robotpicks/rp1/simulation/README.md

# Bonus: DroneCAN-level simulation (no hardware, but real DroneCAN wire traffic)

`rp1_mvp.launch.py use_mock:=true` is the primary way to check the ROS2 architecture with zero
hardware -- see the top-level README and `docs/wiring.md`. It stops at the hardware boundary
though: `mock_components/GenericSystem` loops commands back to states, so nothing below
`vesc_dronecan_driver` is exercised at all.

This directory is that missing step: it runs the **real** `vesc_dronecan_driver` -- actual
DroneCAN framing over a CAN bus, both drive wheels and steering actuators -- against software
stand-ins for the VESCs, using a Linux virtual CAN interface instead of a physical adapter.

## One-time setup: `vcan0`

Requires root (not automatable from a sandboxed session -- run these yourself):
```bash
sudo modprobe vcan
sudo ip link add dev vcan0 type vcan
sudo ip link set up vcan0
```

This doesn't survive a reboot -- the interface is gone until the three commands above are run
again. For a development machine that repeatedly needs `smoke dronecan` or the simulator, make it
permanent with a systemd oneshot unit instead (stack-agnostic -- works regardless of
NetworkManager/networkd/netplan):

```bash
echo vcan | sudo tee /etc/modules-load.d/vcan.conf

sudo tee /etc/systemd/system/vcan0.service <<'EOF'
[Unit]
Description=Bring up virtual CAN interface vcan0
After=network-pre.target
Before=network.target
Wants=network-pre.target

[Service]
Type=oneshot
ExecStart=/sbin/ip link add dev vcan0 type vcan
ExecStart=/sbin/ip link set up vcan0
RemainAfterExit=yes

[Install]
WantedBy=multi-user.target
EOF

sudo systemctl daemon-reload
sudo systemctl enable --now vcan0.service
```

CI doesn't need this -- `.github/workflows/rp1.yml`'s `dronecan-vcan` job creates `vcan0` fresh on
each ephemeral runner.

## Run: drive wheels (`vesc_dronecan_driver`)

The whole thing is wrapped up as one command from the meta repo, which starts both sides, asserts
the round trip, and tears down — this is what CI runs:

```bash
./robotpicks.sh smoke dronecan       # DRONECAN_IFACE=vcan0 by default
```

To drive it by hand instead:

```bash
python3 simulation/sim_vesc_node.py --iface vcan0        # pretends to be the 4 VESCs

source /opt/ros/$ROS_DISTRO/setup.bash
source ros2_ws/install/setup.bash
ros2 launch rp1_bringup rp1_mvp.launch.py can_iface:=vcan0 teleop:=false
```

Then drive it like real hardware: publish a `geometry_msgs/TwistStamped` to
`/diff_drive_controller/cmd_vel`, or drop `teleop:=false` to steer it with a gamepad.
`/joint_states` and `/dynamic_joint_states`
should start showing plausible rpm/voltage/current once `sim_vesc_node.py` receives commands.

`check_dronecan_loopback.py` is the assertion half, usable on its own against an already-running
pair. It publishes a known `TwistStamped`, checks the wheel velocity that comes back in
`/joint_states`, checks per-ESC voltage reaches `/dynamic_joint_states`, then stops publishing and
checks `diff_drive_controller`'s `cmd_vel_timeout` returns the wheels to zero — so it fails if
telemetry never arrives, arrives at the wrong scale, or latches the last command.

The scale check is the interesting one: the commanded speed only survives the round trip
(rad/s → mechanical RPM → ERPM → `sim_vesc_node` → mechanical RPM → rad/s) if `motor_pole_pairs`
in `rp1_drive.urdf` matches `sim_vesc_node.py --pole-pairs`. Both default to 10 (20-pole motor,
10 pole pairs). Run this against
the real hardware component, not `use_mock:=true` — mock leaves the ESC telemetry at NaN and the
voltage phase will (correctly) fail.

## Run: steering actuators (`vesc_dronecan_driver`)

```bash
python3 simulation/sim_actuator_node.py --iface vcan0    # pretends to be the steering VESCs
                                                           # (default actuator_id 5,6; pass
                                                           # --actuator-ids 4,5,6,7 for all 4)

source /opt/ros/$ROS_DISTRO/setup.bash
source ros2_ws/install/setup.bash
# vesc_dronecan_driver talks SocketCAN directly, and ros2_control reads hardware params from the
# robot description only -- so unlike the drive bringup there is no can_iface launch argument
# here. Edit rp1_steering.urdf's <param name="can_iface"> to vcan0 for this test.
ros2 launch rp1_bringup steering_bench.launch.py
```

`sim_vesc_node.py` and `sim_actuator_node.py` can run simultaneously on the same `vcan0` (use
distinct `--node-id` values, they default to 10 and 11 respectively) to exercise the full
4-wheel + 4-steering setup at once.

## Dependencies

`dronecan` and `python-can` (needed by these simulator scripts only, not by the ROS2 stack,
which uses the vendored C libcanard) -- neither
script has a ROS2 dependency, only these.
