robotpicks/rp1/ros2_ws/src/rp1_swerve_controller/README.md

# rp1_swerve_controller

`ros2_control` `controller_interface::ControllerInterface` plugin for rp1's 4-corner swerve
base. On `master` since the `swerve` branch merged (the default MVP bringup still runs
4-wheel-only skid-steer via `diff_drive_controller` — this hasn't replaced that pipeline, just
added an opt-in swerve one alongside it) — see `rp1-specs/requirements.md` ("Why swerve, and what
it needs to do") for the operating modes this needs to support, and
`rp1-specs/software_spec.md`'s "Swerve controller" section for the broader status.

## What's here

- Claims 4 drive velocity command interfaces + 4 steering position command interfaces, named via
  the `drive_joints`/`steering_joints` parameters (each a list of exactly 4 names, in
  front_left/front_right/rear_left/rear_right order — matches `docs/can_id_map.md`'s wheel index
  convention). Also claims a `seek_home` command interface, `home_0deg`/`home_90deg` `<gpio>`
  state interfaces, and a `brake` command interface per steering joint, unless
  `steering_home_sensors_available`/`steering_brake_available` (both default `true`, independent
  of each other) are set `false` — see the homing gate, brake, and Gazebo bullets below for why
  those escape hatches exist.
- Subscribes `~/cmd_vel` (`geometry_msgs/TwistStamped`, matching `rp1_teleop`'s output and
  `diff_drive_controller`'s convention on this ROS 2 release), guarded by the `cmd_vel_timeout`
  staleness watchdog — see its bullet below.
- Lifecycle (`on_init`/`on_configure`/`on_activate`/`on_deactivate`) and `update()` are wired
  end-to-end and safe to load/activate.
- **Real swerve inverse kinematics.** `compute_corner_commands()` decomposes `(vx, vy, wz)` into
  each corner's wheel speed + steering angle at its steering-axis position
  (`half_wheelbase`/`half_track` params), with the angle-flip optimization (rotate ≤90° and
  reverse wheel speed instead of always steering to the literal computed angle) tracked against
  an unwrapped last-commanded-angle per corner.
- **The four operating modes from `rp1-specs/requirements.md`**, selected via `~/mode`
  (`std_msgs/UInt8`, `SwerveMode` in the header):
  - `0` **FULL_SWERVE** (default) — all 4 corners independently steered, as above.
  - `1` **LOCKED_0** — all 4 wheels held at 0°, driven by projecting the same rigid-body-twist
    vector onto that fixed direction — algebraically identical to standard skid-steer
    differential drive (`vx ∓ wz·half_track` per side). `vy` has no effect (can't strafe with
    wheels locked forward).
  - `2` **LOCKED_90** — all 4 wheels held at 90° (pure crab), same projection trick. `vx` has no
    effect (can't drive fore/aft with wheels locked sideways).
  - `3` **TWO_WHEEL** — 2 corners free-steer via the full IK above, the other 2 locked at 0°
    like `LOCKED_0`. **Which 2 is the `two_wheel_steered_corners` parameter** (a list of exactly
    2 of `front_left`/`front_right`/`rear_left`/`rear_right`), not fixed in code — default is
    the front pair (a conventional front-steered vehicle), but one front + one rear, both on one
    side, or diagonal corners are equally valid. Ackermann-like, though not true Ackermann
    geometry (no explicit turn-radius computation) — a deliberate simplification reusing the
    existing per-corner IK/lock machinery.
  - Locked corners skip the angle-flip optimization on purpose — a "locked" wheel should stay
    visually fixed at its locked angle, not flip to the opposite angle with reversed speed even
    though that's motion-equivalent. Unrecognized `~/mode` values fail safe to `FULL_SWERVE`
    rather than erroring.
  - Verified (gtest, with the corners' `home_0deg`/`home_90deg` pre-confirmed so the homing gate
    below doesn't mask the math being checked): `LOCKED_0`/`LOCKED_90`/`TWO_WHEEL` all produced
    exact numeric matches to hand-calculated expected wheel speeds/angles (including the
    front/rear or left/right differential split from `wz`), switching back to `FULL_SWERVE` —
    and an out-of-range mode value — both correctly fall back to the unconstrained IK, and
    overriding `two_wheel_steered_corners` to a non-default pair (`front_left`/`rear_left`,
    a front+rear diagonal-ish pair rather than the default front pair) correctly moved which 2
    corners free-steer.
- **Homing-gated locked-mode transitions.** Fixes the gap `rp1-specs/requirements.md` flagged
  ("a mode switch takes effect immediately based on whatever angle the controller last
  commanded, not a verified position"): `compute_corner_commands()` reads each locked corner's
  live `home_0deg`/`home_90deg` `<gpio>` state every cycle (no separate "have we ever homed"
  bookkeeping needed — a corner that later drives off the reference naturally stops reporting it
  and re-gates the next time a locked mode needs it), via the `steering_home_sensors` parameter
  (4 gpio prefix names, defaulting to `rp1_swerve.urdf`'s `steering_sensors_*` naming). While
  *any* corner that needs a fixed reference for the current mode isn't yet confirmed there, every
  drive wheel is held at zero (the whole chassis, not just that corner — a mix of confirmed and
  unconfirmed locked wheels would drag/scrub if the drive wheels moved) and the corner's
  `seek_home` command interface carries `0.0`/`1.0` (edge-triggered, matching
  `vesc_dronecan_driver`'s convention — `NaN` means no active request, written once confirmed or
  when the corner isn't locked at all this mode). The corner's steering position command still
  targets the locked angle as usual, so it visibly rotates in place to seek its sensor even
  though the chassis doesn't translate. `FULL_SWERVE` never gates on anything (no fixed
  reference to verify). Verified both via gtest (an unhomed `LOCKED_0`/`LOCKED_90` switch holds
  all 4 wheels at zero and requests the right `seek_home` target; confirming the sensor resumes
  driving with the exact previously-verified locked-mode numbers; a partially-homed corner still
  holds the whole chassis; `TWO_WHEEL`'s free-steering pair never gates) and live: against
  `rp1_swerve_mock.launch.py` (mock hardware never confirms homing, since nothing simulates the
  proximity sensors, so `LOCKED_0` correctly holds `/joint_states` at zero indefinitely) and
  against `rp1_swerve_dronecan.launch.py` over `vcan0` (same zero-hold, plus a raw DroneCAN
  sniff confirmed exactly one `COMMAND_TYPE_HOME` `actuator.ArrayCommand` entry per corner
  reaches the wire — not resent every cycle — when switching into `LOCKED_0`).
- **Steering-hold brake**, closing `rp1-specs/requirements.md`'s "Brake on steering requirement"
  gap (the 4:1 spur reduction isn't self-locking, so holding a locked angle without continuously
  drawing motor current needs an actual brake — the firmware side, `bldc`'s `COMMAND_TYPE_BRAKE`,
  already existed; this was the missing `ros2_control` representation). A `brake` command
  interface per steering joint, `vesc_dronecan_driver` sends it as a `COMMAND_TYPE_BRAKE`
  `actuator.Command` entry every cycle — level, not edge-triggered like `seek_home`, so a dropped
  frame self-heals rather than leaving the brake stuck. Engaged (`1.0`) exactly when a corner is
  `locked && confirmed` — the same condition that stops gating drive to zero — released (`0.0`)
  otherwise: free-steering corners, or a locked corner still seeking/unconfirmed (the firmware's
  `homing_tick()` needs the shaft free to turn during the seek, and would otherwise fight an
  engaged brake). Verified both via gtest (engages once confirmed, releases while pending, stays
  released on free-steering corners including `TWO_WHEEL`'s free pair) and live over `vcan0`: the
  brake stays released while `LOCKED_0` is requested but unconfirmed, and a raw wire sniff
  confirmed `COMMAND_TYPE_BRAKE` reaches `actuator.ArrayCommand` continuously (not just once, per
  its level rather than edge-triggered semantics) with the expected value.
- **Mode-switch safety: a requested mode only becomes active once the chassis is confirmed
  actually stopped.** Complements the homing gate above rather than replacing it — that gate
  only fires when a corner's target angle isn't yet confirmed; this one is a blanket rule
  covering every mode transition, including ones where no corner's target angle actually
  changes (e.g. `LOCKED_0`→`TWO_WHEEL`'s default pair, both wanting the same 0° for the locked
  corners). `update()` computes the real (state-feedback-derived) body twist via
  `compute_body_twist()` every cycle; a requested `~/mode` value only overwrites `active_mode_`
  — the mode `compute_corner_commands()` actually acts on — once `vx`/`vy`/`wz` are all below
  `mode_switch_stopped_tolerance` (default 0.02 m/s or rad/s). Until then, the controller keeps
  running the *previous* mode's kinematics rather than freezing or erroring. Fixed a latent bug
  surfaced while adding this: `compute_body_twist()`'s per-corner state reads used
  `get_optional().value_or(0.0)`, which only substitutes for a genuinely empty optional — a
  state interface that hasn't been reported yet reads back as an *engaged* optional wrapping
  NaN (real hardware before its first telemetry frame, or a bare test-harness interface with no
  `initial_value`), which silently poisoned every downstream sum; now explicitly NaN-checked.
  Verified via gtest (a chassis reporting real motion via drive/steering state defers a
  requested switch, keeping the previous mode's exact numbers, then adopts the new mode with
  the previously-verified locked-mode numbers once state reports near-zero; a controller that's
  never received any state feedback is treated as already stopped, matching every other test in
  the suite) and live against `rp1_swerve_mock.launch.py`: requesting `LOCKED_0` while actively
  driving left the FULL_SWERVE steering angles in place, and only snapped to the locked angle
  once a zero `cmd_vel` let the mock-looped-back state settle near zero.
- **Odometry.** `compute_body_twist()` reads back drive velocity + steering position *state*
  (`wheel_radius` param converts angular velocity to linear speed) and solves the same
  rigid-body-twist equations as the IK, in reverse — exact for this controller's always-
  rectangular corner geometry (see the code comment for why it decouples into 3 independent
  averages rather than needing a general least-squares solver). Integrated pose is published as
  `nav_msgs/Odometry` on `~/odom` and broadcast as an `odom_frame_id`→`base_frame_id` TF
  (defaults `odom`/`base_link`, `enable_odom_tf` to disable), matching `diff_drive_controller`'s
  conventions.
- Verified end-to-end against `rp1_bringup`'s `rp1_swerve_mock.launch.py` (mock hardware, real
  `rp1_swerve.urdf`, no CAN/Gazebo): straight, pure lateral/crab, and turn-in-place all produce
  the expected `/joint_states`, including the angle-flip case actually engaging correctly; and
  driving straight for 5s at 1 m/s produced `~/odom` position ≈5.5m and a matching `odom→
  base_link` TF, confirming the robot actually drives across RViz's grid now, not just
  articulates its joints in place. See that launch file for the "watch it before trusting it on
  the robot" bringup.
- **Real DroneCAN hardware path verified for both drive and steering.**
  `rp1_swerve_dronecan.launch.py` (against `vesc_dronecan_driver`, real wire framing over
  `can0`/`vcan0`) drove straight and produced genuine nonzero drive-wheel velocity/position in
  `/joint_states`; a turn-in-place command produced steering positions matching the
  hand-computed full-swerve angles exactly (`±0.5586 rad` on all 4 corners, alternating sign per
  the angle-flip optimization) — both fed back over actual DroneCAN traffic, a meaningfully
  different trust level than the mock-hardware tier, where odometry is computed from state
  that's just last cycle's command looped back. Getting there required fixing three real bugs
  (all in `vesc_dronecan_ros`'s swerve branch except the dronecan driver-dispatch one): (1)
  `dronecan`'s driver-dispatch bug in the simulator scripts; (2) `pumpRx()` passed a hardcoded
  `timestamp_usec=0` to libcanard, which made every multi-frame transfer (`esc.Status`,
  `actuator.Status`) look "never initialized" on its second frame and get silently dropped —
  single-frame transfers (`esc.RPMCommand`, `actuator.ArrayCommand`) were unaffected, which is
  why this went unnoticed until real feedback was checked; (3) `actuator.Status`'s decoder
  hard-failed the *entire* decode (throwing away position/speed/force too, not just the 2
  extension fields) whenever the private `home_0deg`/`home_90deg` extension bits were absent —
  which they always are from a standard, non-extended sender like `sim_actuator_node.py`. The
  extension bits themselves (and `seek_home`/`COMMAND_TYPE_HOME`) still aren't exercised by
  these simulator scripts, since the stock `dronecan` Python codec doesn't know to populate
  them — only a real bldc-flashed VESC (or a simulator taught the extension) would cover that.
- **Gazebo physics wiring, via `rp1_swerve_gazebo.launch.py`.** `gz_ros2_control`'s
  `GazeboSimSystem` replaces `vesc_dronecan_driver`/`mock_components` — the first tier where
  drive/steering feedback comes from an actual simulated rigid-body dynamics solver (inertia,
  gravity, contact), not commands looping straight back to state or a real DroneCAN round-trip
  with no physics at all. GazeboSimSystem only backs standard joint interfaces (position/
  velocity/effort) with a real Gazebo entity, so it can't export `seek_home`/`brake` or any
  `<gpio>` interface (ESC telemetry, `home_0deg`/`home_90deg`) — no Gazebo entity to back those
  with. Since `controller_manager`'s resource manager refuses to activate a controller that
  declares an interface no hardware component exports, this can't be requested-then-tolerated-
  if-missing the way an unexpectedly-absent `steering_home_sensors` name is:
  `steering_home_sensors_available`/`steering_brake_available` parameters (both default `true`)
  tell the controller not to request `seek_home`/`home_0deg`/`home_90deg`/`brake` at all, set to
  `false` for this tier via `rp1_swerve_gazebo_overrides.yaml`. Practically this means home
  confirmation is permanently unavailable under Gazebo (same situation as mock hardware, for the
  same reason — nothing
  simulates the proximity sensors), so only `FULL_SWERVE` drives; `LOCKED_0`/`LOCKED_90`/
  `TWO_WHEEL` stay correctly gated at zero forever. Verified live: both `joint_state_broadcaster`
  and `rp1_swerve_controller` activate cleanly against the spawned model, and driving straight
  produced real closed-loop feedback through actual physics — wheel velocity converging toward
  (not instantly snapping to) the commanded value, `~/odom` and the broadcast TF both advancing
  with real accumulated distance. Two real bugs fixed getting there, both launch-file-level, not
  controller bugs: the URDF's own explanatory comment happened to contain the same placeholder
  text used for the `<parameters>` path substitution, so a naive `count=1` regex replaced the
  comment's occurrence instead of the tag's; and spawners need `--param-file` here exactly like
  the other two tiers already document, even though `gz_ros2_control`'s plugin separately loads
  the same YAML for its own `controller_manager`'s `ros__parameters` (that only covers
  controller *type* declarations, not each controller's own parameters). Two further real bugs
  fixed on top of the above, both discovered while live-testing Gazebo tuning (see the next two
  bullets):
- **Units bug in the drive command: `compute_corner_commands()` sent linear m/s straight to the
  angular (rad/s) velocity command interface.** `compute_body_twist()` (the reverse/odometry
  path) correctly multiplies the state-reported angular velocity by `wheel_radius` to get linear
  speed, but the forward/IK path had no matching divide — every commanded speed reached the wheel
  `wheel_radius` (0.2154) times too fast in the interface's own units, so the physical wheel (and
  the robot) moved at only `wheel_radius` times the commanded m/s (e.g. `vx=1.0` produced ~0.215
  m/s of real motion). Invisible before because odometry is self-consistent with whatever the
  wheel actually did, not compared against the commanded value directly — only surfaced by
  comparing Gazebo's converged `/joint_states` velocity against the independently-computed
  expected value while tuning PID gains. Fixed by dividing by `wheel_radius` in
  `compute_corner_commands()`, matching `compute_body_twist()`'s multiply in reverse. Verified via
  gtest (all `drive_command` expected values recomputed against the corrected units) and live over
  Gazebo (`/joint_states` wheel velocity converges to exactly `commanded_m_s / wheel_radius`
  rad/s, confirmed against `vx=1.0` -> `4.6425` rad/s).
- **Gazebo PID/physics tuning: the URDF was missing `<limit effort="".../>`/`<dynamics
  damping="".../>` on every drive and steering joint, and steering had no declared
  `position_proportional_gain`.** `gz_ros2_control`'s `GazeboSimSystem` only exposes
  `position_proportional_gain` as a real parameter for position control (confirmed via `strings`
  on `libgz_ros2_control-system.so` — no separate velocity gain exists in this version); combined
  with the URDF's total absence of effort/velocity/damping limits, convergence toward a
  step-changed target was implausibly slow. Fixed by adding `<limit effort="10.0"
  velocity="10.0"/>` + `<dynamics damping="0.1" friction="0.0"/>` to the 4 steering joints,
  `<limit effort="20.0" velocity="50.0"/>` + the same damping to the 4 drive joints, and
  `<param name="position_proportional_gain">50.0</param>` to each steering joint's
  `<ros2_control>` block — all untuned placeholders, not measured/optimized values, but enough to
  fix the qualitative sluggishness. Verified live: before/after `/joint_states` comparison showed
  convergence going from "gradually settles over the whole test window" to "near-instant."
- **Mode-switch ramping.** Closes the "no ramping" gap `rp1-specs/requirements.md` flagged: the
  mode-switch-safety gate above only ever *waited* for the chassis to report near-zero twist —
  it never itself commanded a stop, so a caller that kept publishing a nonzero `~/cmd_vel` could
  block a requested switch forever. Now, once a switch is pending (`requested_mode !=
  active_mode_`) and the chassis isn't yet stopped, the raw `~/cmd_vel` is ignored in favor of a
  ramp: `ramp_vx_`/`ramp_vy_`/`ramp_wz_` are seeded from whatever `~/cmd_vel` said the cycle the
  switch first became pending, then decelerated toward zero every cycle at
  `mode_switch_linear_deceleration`/`mode_switch_angular_deceleration` (m/s²/rad/s², both default
  to reasonable-feeling placeholders, not measured/tuned values) regardless of what `~/cmd_vel`
  keeps publishing — so the chassis reliably reaches `mode_switch_stopped_tolerance` and the
  switch lands. Once it does, `~/cmd_vel` passes through unchanged again, same as before this
  feature existed. Verified via gtest (a strictly-decreasing `drive_command` sequence across
  several cycles while `~/cmd_vel` keeps holding its original nonzero value, then settling at
  exactly zero and staying there) and live over Gazebo: requesting `LOCKED_0` while continuously
  publishing `vx=1.0` showed wheel velocity smoothly decelerating from steady-state (~4.64 rad/s)
  to zero over ~2s (matching the default deceleration rate), after which steering committed to
  the locked 0° angle.
- **`cmd_vel` staleness watchdog.** `diff_drive_controller`'s `cmd_vel_timeout`, which the MVP
  skid-steer path already relies on (and CI's DroneCAN loopback check asserts), had no
  counterpart here: `update()` latched the last twist forever, so a dead publisher — teleop
  crash, RC dropout, or just a `ros2 topic pub` that exited — left the robot driving its last
  command indefinitely (observed for real under Gazebo: still strafing at 0.3 m/s a minute after
  the publisher stopped). Now a command whose `header.stamp` is older than `cmd_vel_timeout`
  (seconds, default 0.5, validated > 0) is treated as no command at all: every drive velocity
  goes to zero while the steering positions keep holding the last commanded angle — coasting out
  straight beats snapping the wheels back to 0° mid-roll, which would scrub. Unstamped messages
  are stamped at reception so they age correctly; a fresh command revives driving immediately
  (the watchdog gates on message age, not a latched fault).

## What's not here yet

Nothing currently tracked here — the previously-open "no ramping" and "untuned Gazebo PID gains"
gaps are both closed above.

## Tests

`test/test_rp1_swerve_controller.cpp` — 24 gtest cases, run via `colcon test --packages-select
rp1_swerve_controller`. Builds a real controller instance with real `CommandInterface`/
`StateInterface` objects (not a mock hardware component), drives the actual lifecycle
(`init`/`configure`/`assign_interfaces`/`activate`), and delivers `cmd_vel`/`mode` via real
publishers spun through a `SingleThreadedExecutor` (not direct field writes) so the subscription
wiring itself is exercised, not just the math. Covers straight/crab/turn-in-place (including
asserting the angle-flip optimization's exact expected values on the two corners where it should
engage), `LOCKED_0`/`LOCKED_90`, `TWO_WHEEL` with both the default and an overridden
`two_wheel_steered_corners` pair, the out-of-range-mode fallback, odometry (drives state
interfaces directly, subscribes `~/odom`, checks the published value), the homing gate (an
unhomed `LOCKED_0`/`LOCKED_90` switch holds every drive wheel at zero and issues the right
`seek_home` target, confirming the sensor afterward resumes driving with the same numbers the
non-gated tests check; a partially-homed corner (3 of 4) still holds the whole chassis; `TWO_WHEEL`
gates on its locked pair only, never the free-steering one; and `FULL_SWERVE` never gates
regardless of home state), the mode-switch-safety gate (a chassis reporting real motion via
drive/steering state defers a requested switch, adopting it only once state settles near zero;
a controller that's never received state feedback is treated as already stopped), mode-switch
ramping (a deferred switch's drive command strictly decreases cycle-over-cycle while `~/cmd_vel`
keeps holding its original nonzero value, settling at exactly zero and staying there), the
`cmd_vel` staleness watchdog (a stale command zeroes every drive velocity while steering holds
the last angle; a fresh one within the timeout keeps driving; a non-positive `cmd_vel_timeout`
fails `on_init`), and
`steering_home_sensors_available`/`steering_brake_available:false` (mirroring Gazebo: no
seek_home/home_0deg/home_90deg/brake interfaces assigned at all, not just unconfirmed) -- the
controller still activates and drives `FULL_SWERVE` normally, and `LOCKED_0` stays gated at zero
across several cycles, not just the first. The brake itself: engages once a locked corner is
confirmed, releases while pending, and stays released on `TWO_WHEEL`'s free-steering pair.

Not chainable (`controller_interface::ControllerInterface`, not `ChainableControllerInterface`)
— unlike this ROS 2 release's `diff_drive_controller`/`mecanum_drive_controller`. Revisit only if
something actually needs to chain into/out of this controller; not needed for anything currently
planned.
