robotpicks/rp1/docs/mechanical_request.xlsx

Sheet: 0. Instructions
rp1 — Geometry & Mass Properties Request
Request to Mechanical Design / Запрос в отдел механического проектирования
 | ENGLISH | РУССКИЙ
Document | rp1 — Geometry & Mass Properties Request, Rev A | rp1 — Запрос геометрических данных и массово-инерционных характеристик, ред. A
Date / Дата | 2026-07-26 | 2026-07-26
From / От | Nir Mor — Software / ROS 2 (nir@nadirwave.com) | Нир Мор — ПО / ROS 2 (nir@nadirwave.com)
To / Кому | Mechanical Design | Отдел механического проектирования
Purpose / Цель | The rp1 software stack has no physical description of the robot. Kinematics, odometry and simulation currently run on placeholder numbers (track width 0.5 m, wheelbase 0.5 m, wheel radius 0.1 m) and the URDF is a two-joint skeleton with every joint at the origin. This workbook collects the real values. | В программном стеке rp1 отсутствует физическое описание робота. Кинематика, одометрия и симуляция работают на условных значениях (колея 0,5 м, колёсная база 0,5 м, радиус колеса 0,1 м), а URDF — заготовка из двух шарниров в начале координат. Настоящая книга собирает реальные значения.
How to use / Как заполнять | Fill in only the cream-coloured cells. Sheets 1, 2 and 5 are confirmations; sheets 3, 3.1-3.2 and 4 are numeric values. Do not delete or renumber rows — the Ref column is referenced by the PDF and by the software configuration. | Заполняйте только ячейки кремового цвета. Листы 1, 2 и 5 — подтверждения; листы 3, 3.1-3.2 и 4 — числовые значения. Не удаляйте и не перенумеровывайте строки — графа Ref используется в PDF и в конфигурации ПО.
Units / Единицы | Metres, radians, kilograms. Right-handed frame, X forward / Y left / Z up (ROS REP-103). Confirm on sheet '1. Conventions' before entering any value. | Метры, радианы, килограммы. Правая система координат, X — вперёд / Y — влево / Z — вверх (ROS REP-103). Подтвердите на листе «1. Conventions» до внесения значений.
Source column / Графа Source | CAD = as-designed value from the model. MEAS = measured on built hardware. Every value needs one of the two — both are kept, they do not replace each other. | CAD = значение по конструкторской документации (из модели). MEAS = измерено на изготовленном изделии. Требуется указать для каждого значения — оба набора хранятся и не заменяют друг друга.
Tolerance / Допуск | Give a tolerance per value, or state a blanket tolerance for a group in the Notes column. | Указывайте допуск для каждого значения либо общий допуск на группу в графе «Примечания».
Files / Файлы | The workbook does not replace the file deliverables — see sheet '2. Files' for the STEP, mesh, drawing and mass-property exports requested alongside it. | Книга не заменяет передаваемые файлы — см. лист «2. Files»: STEP, полигональные модели, чертежи и массово-инерционные характеристики запрашиваются дополнительно.
Return to / Вернуть | nir@nadirwave.com — this workbook filled in, plus the files from sheet 2. | nir@nadirwave.com — заполненную книгу и файлы по листу 2.
Legend / Обозначения | Cream cell = to be filled in by mechanical design | Кремовая ячейка = заполняется отделом механики

Sheet: 1. Conventions
§1 — Coordinate frame and conventions / Система координат и соглашения
Agree these BEFORE exchanging any numbers — a mismatch invalidates every value in §3. / Согласовать ДО обмена числами — расхождение обесценивает все значения §3.
Ref | Item (EN) | Пункт (RU) | Requested convention (EN) | Запрашиваемое соглашение (RU) | Confirmed Подтверждено | Comment / Комментарий
1.1 | Units | Единицы измерения | Length in metres, angles in radians, mass in kg | Длина — метры, углы — радианы, масса — кг
1.2 | Handedness | Ориентация системы | Right-handed coordinate system | Правая система координат
1.3 | Axis convention | Направление осей | X forward, Y left, Z up (ROS REP-103) | X — вперёд, Y — влево, Z — вверх (ROS REP-103)
1.4 | base_link origin | Начало координат base_link | Proposed: ground projection of the geometric centre of the four steering axes | Предлагается: проекция на грунт геометрического центра четырёх осей поворота колёс
1.5 | base_link tie-in | Привязка base_link | Offset from base_link to a physical feature measurable on the built frame (e.g. front face of the chassis rail, centreline of a specific bore) — state which feature | Смещение от base_link до физического элемента, измеримого на изготовленной раме (например, передняя плоскость лонжерона, ось конкретного отверстия) — указать, какого именно
1.6 | Assembly datums | Базы сборки | Which faces/features are the primary, secondary and tertiary datums | Какие поверхности/элементы являются основной, вспомогательной и третьей базами
1.7 | Zero pose — steering | Нулевое положение — поворот | Steering angle 0 = wheel plane aligned with +X; positive rotation counter-clockwise about +Z (viewed from above) | Угол поворота 0 = плоскость колеса совпадает с +X; положительное вращение — против часовой стрелки вокруг +Z (вид сверху)
1.8 | Zero pose — drive | Нулевое положение — тяга | Positive wheel rotation = robot moves forward | Положительное вращение колеса = движение робота вперёд
1.9 | Export pose | Положение при экспорте | All geometry exported with the robot in the zero pose defined above | Вся геометрия экспортируется в нулевом положении, определённом выше
1.10 | Unit conversion applied | Применённый пересчёт единиц | CAD packages commonly default to millimetres and Y-up. State the conversion actually applied to the exported files rather than leaving it implied. | В CAD-системах часто приняты миллиметры и ось Y вверх. Явно указать пересчёт, фактически применённый к экспортируемым файлам.

Sheet: 2. Files
§2 — Files requested / Запрашиваемые файлы
The workbook does not replace these exports. / Настоящая книга не заменяет эти файлы.
Ref | Deliverable (EN) | Результат (RU) | Format / Формат | Notes / Примечания | Status Статус | File name(s) / Имена файлов
2.1 | Full assembly, as-designed | Полная сборка по конструкторской документации | STEP AP242 (AP214 acceptable) | Master geometry, in the zero pose of §1 / Эталонная геометрия, в нулевом положении по §1
2.2 | Per-link visual meshes | Полигональные модели (визуальные) по звеньям | Binary STL or Collada .dae, one file per link | Decimated (~10k-100k triangles total), in metres, each file's origin at that link's joint / Упрощённые (~10–100 тыс. треугольников), в метрах, начало координат — в шарнире звена
2.3 | Per-link collision geometry | Геометрия для расчёта столкновений по звеньям | Primitives (box / cylinder / sphere) or convex hulls | Must be separate from 2.2 — the detailed mesh is not usable for collision checking / Должна быть отдельной от 2.2 — детализированная модель непригодна
2.4 | Dimensioned drawings | Чертежи с размерами | PDF | Top, side and front views with datums shown / Виды сверху, сбоку и спереди с указанием баз
2.5 | Mass properties | Массово-инерционные характеристики | CSV or table / CSV или таблица | Per link: mass, centre of mass, 3x3 inertia tensor about the CoM, and the frame it is expressed in / По звену: масса, центр масс, тензор инерции 3×3 относительно ЦМ и система координат
2.6 | Parameter table | Таблица параметров | This workbook / Настоящая книга | Versioned together with the CAD revision / Версионируется совместно с ревизией CAD
2.7 | URDF exporter output (if available) | Результат экспортёра URDF (при наличии) | URDF + meshes | SolidWorks sw_urdf_exporter, Onshape onshape-to-robot, Fusion 360 — supply in addition to 2.6, not instead of it / предоставить в дополнение к 2.6, а не вместо него

Sheet: 3. Parameters
§3 — Geometric parameters (scalar) / Геометрические параметры
Per-corner values are on the '3.1-3.2 Per-corner' sheet. / Значения по углам машины — на листе «3.1-3.2 Per-corner».
Ref | Parameter (EN) | Параметр (RU) | Unit Ед. | Value Значение | Tol. Допуск | Source Источник | Notes / Примечания
3.1 Wheel layout — track and wheelbase / Расположение колёс — колея и база
3.1.1 | Front track width (between wheel contact patch centrelines) | Передняя колея (между центрами пятен контакта) | m / м
3.1.2 | Rear track width (between wheel contact patch centrelines) | Задняя колея (между центрами пятен контакта) | m / м
3.1.3 | Wheelbase (longitudinal distance, front to rear steering axis) | Колёсная база (продольное расстояние между осями поворота) | m / м
3.3 Wheels and tyres / Колёса и шины
3.3.1 | Unloaded wheel radius | Свободный радиус колеса (без нагрузки) | m / м
3.3.2 | Loaded rolling radius at nominal payload | Радиус качения под номинальной нагрузкой | m / м
3.3.3 | Tyre pressure at which 3.3.2 applies | Давление в шине, при котором действует п. 3.3.2 | bar / бар
3.3.4 | Tyre section width | Ширина профиля шины | m / м
3.3.5a | Contact patch length at nominal load | Длина пятна контакта при номинальной нагрузке | m / м
3.3.5b | Contact patch width at nominal load | Ширина пятна контакта при номинальной нагрузке | m / м
3.3.6 | Tread type / part number | Тип протектора / обозначение шины | —
3.4 Steering joints and drivetrain / Механизмы поворота и трансмиссия
3.4.1 | Steering joint: true continuous 360° rotation? | Механизм поворота: непрерывное вращение на 360°? | Yes/No
3.4.2a | If No: steering joint limit, min | Если Нет: предел поворота, мин. | rad / рад
3.4.2b | If No: steering joint limit, max | Если Нет: предел поворота, макс. | rad / рад
3.4.3 | If No: what imposes the limit (cable routing / mechanical stop / other) | Если Нет: чем ограничен ход (прокладка кабеля / механический упор / иное) | —
3.4.4 | Steering reduction ratio, actuator -> steering axis | Передаточное отношение привода поворота, привод → ось поворота | :1
3.4.5 | Drive reduction ratio, motor -> wheel | Передаточное отношение тягового привода, двигатель → колесо | :1
3.4.6 | Backlash referred to the wheel (drive) | Люфт, приведённый к колесу (тяга) | rad / рад
3.4.7 | Backlash referred to the steering axis | Люфт, приведённый к оси поворота | rad / рад
3.4.8 | Max steering rate the mechanism tolerates | Максимальная скорость поворота, допускаемая механизмом | rad/s
3.4.9 | Design max wheel speed | Расчётная максимальная скорость колеса | m/s
3.4.10a | Required wheel torque, continuous | Требуемый момент на колесе, длительный | N·m / Н·м
3.4.10b | Required wheel torque, peak | Требуемый момент на колесе, пиковый | N·m / Н·м
3.4.11 | Required steering torque at standstill on soil | Требуемый момент поворота колеса на месте по грунту | N·m / Н·м
3.5 Envelope, mass and operating limits / Габариты, масса и ограничения
3.5.1a | Overall length | Габаритная длина | m / м
3.5.1b | Overall width | Габаритная ширина | m / м
3.5.1c | Overall height | Габаритная высота | m / м
3.5.2a | Minimum ground clearance | Минимальный дорожный просвет | m / м
3.5.2b | Where the minimum clearance occurs | Место расположения минимального просвета | —
3.5.3a | Approach angle | Угол въезда | rad / рад
3.5.3b | Departure angle | Угол съезда | rad / рад
3.5.4 | Total mass (dry, no payload) | Полная масса (снаряжённая, без полезной нагрузки) | kg / кг
3.5.5a | Static load, front left (FL) | Статическая нагрузка, переднее левое (FL) | kg / кг
3.5.5b | Static load, front right (FR) | Статическая нагрузка, переднее правое (FR) | kg / кг
3.5.5c | Static load, rear left (RL) | Статическая нагрузка, заднее левое (RL) | kg / кг
3.5.5d | Static load, rear right (RR) | Статическая нагрузка, заднее правое (RR) | kg / кг
3.5.6x | Centre of mass in base_link, x | Центр масс в base_link, x | m / м
3.5.6y | Centre of mass in base_link, y | Центр масс в base_link, y | m / м
3.5.6z | Centre of mass in base_link, z | Центр масс в base_link, z | m / м
3.5.7 | Max payload mass | Максимальная полезная нагрузка | kg / кг
3.5.8 | Payload mounting interface pose — enter on sheet '4. Sensor mounts' | Положение посадочного места полезной нагрузки — вносится на листе «4. Sensor mounts» | —
3.5.9a | Rated max slope (drive) | Максимальный преодолеваемый уклон | rad / рад
3.5.9b | Static tip-over angle | Статический угол опрокидывания | rad / рад
3.5.10 | Target row spacing the robot must straddle or pass | Ширина междурядья, которое робот должен проходить или обхватывать | m / м
3.5.11 | Max crop canopy height the robot must pass under | Максимальная высота растительного полога для прохода под ним | m / м

Sheet: 3.1-3.2 Per-corner
§3.1 / §3.2 — Per-corner geometry / Геометрия по углам машины
Steering axis position in base_link, and steering axis geometry. Per-corner values are requested so an asymmetric layout is captured correctly. / Положение оси поворота в base_link и геометрия оси поворота — по каждому углу, чтобы описать несимметричную компоновку.
Corner Угол | Steering axis x [m / м] | Steering axis y [m / м] | Steering axis z [m / м] | Scrub radius / lateral offset, axis -> contact patch centre [m] Плечо обкатки / попер. смещение [м] | Trail / longitudinal offset [m] Продольное смещение (вылет) [м] | Caster angle [rad] Кастер [рад] | Camber angle [rad] Развал [рад] | Source Источник | Notes / Примечания
FL |  |  |  |  |  |  |  |  | Front Left / Переднее левое
FR |  |  |  |  |  |  |  |  | Front Right / Переднее правое
RL |  |  |  |  |  |  |  |  | Rear Left / Заднее левое
RR |  |  |  |  |  |  |  |  | Rear Right / Заднее правое
 | All four corners identical? If yes, fill FL only and note it here. / Все четыре угла идентичны? Если да, заполните только FL и укажите это здесь.

Sheet: 4. Sensor mounts
§4 — Sensor and mount frames / Системы координат посадочных мест
Requested now even though sensor selection is not final — the interfaces must be reserved in the design and the poses feed the ROS 2 transform tree. Pose is of the mount in base_link. / Запрашивается уже сейчас: посадочные места надо зарезервировать, а их положения используются для дерева преобразований TF. Положение задаётся в base_link.
Mount / Посадочное место | x [m / м] | y [m / м] | z [m / м] | roll [rad] крен [рад] | pitch [rad] тангаж [рад] | yaw [rad] рыскание [рад] | Bolt pattern Присоед. размеры | Source Источник | Notes / Примечания
IMU / ИНС
GNSS antenna — phase centre / Антенна ГНСС — фазовый центр
Forward camera / lidar — Передняя камера / лидар
Rear camera / lidar — Задняя камера / лидар
Payload plate (§3.5.8) / Плита полезной нагрузки
Spare mount 1 / Резервное место 1
IMU axis orientation / Ориентация осей IMU | State the IMU axis orientation relative to base_link explicitly, not only the mount pose. A rotated or inverted IMU is the most common source of sign errors in the control loop. / Укажите ориентацию осей IMU относительно base_link явно, а не только положение посадочного места. Повёрнутая или перевёрнутая установка IMU — самая частая причина ошибок в знаках.

Sheet: 5. Process
§5 — Tolerances, revisions and process / Допуски, ревизии и порядок работы
Ref | Item (EN) | Пункт (RU) | Agreed Согласовано | Comment / Комментарий
5.1 | Every value in §3-§4 marked CAD (as-designed) or MEAS (measured on hardware) | Каждое значение в §3–§4 помечено как CAD (по документации) или MEAS (измерено на изделии)
5.2 | Tolerance given for each value, or a blanket tolerance stated for a group | Для каждого значения указан допуск либо задан общий допуск на группу
5.3 | This workbook is issued with each CAD revision, carrying that revision's ID | Настоящая книга выпускается с каждой ревизией CAD и содержит идентификатор этой ревизии
5.4 | Software is notified when any §3 value changes, including "small" changes | О любом изменении значений §3 сообщается разработчикам ПО, включая «незначительные»
 | Rationale for 5.4: these values are duplicated across three ROS 2 configuration files and the robot description. A silent change breaks the correspondence between simulation and hardware in a way no automated test detects. Wheel-odometry calibration on the built robot will refine the effective track width and rolling radius; those calibrated values do not replace the CAD values — both are kept, which is why the CAD/MEAS marking matters. / Обоснование п. 5.4: эти значения продублированы в трёх конфигурационных файлах ROS 2 и в описании робота. Необъявленное изменение нарушает соответствие симуляции и реальной машины так, что автоматические тесты этого не выявляют. Калибровка колёсной одометрии уточнит эффективную колею и радиус качения, но не заменяет значения из CAD — хранятся оба набора.
