robotpicks/rp1/ros2_ws/src/rp1_description/meshes/wheel_front_left.stl

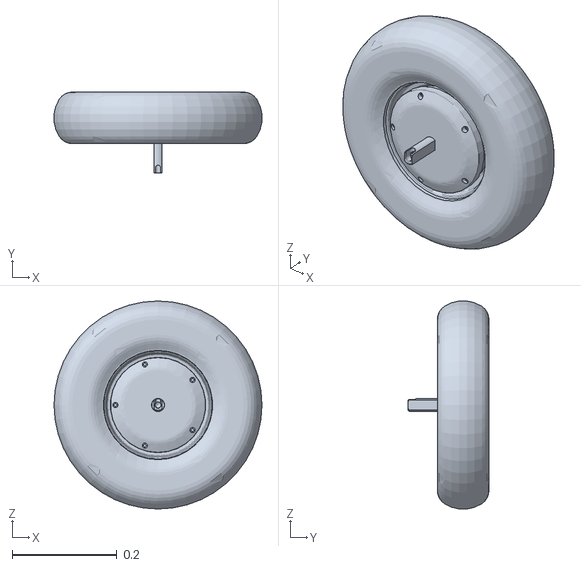
[picture p1: CAD file, 2026-07-27]
ros2_ws/src/rp1_description/meshes/wheel_front_left.stl
0.397 x 0.155 x 0.397
