robotpicks/rp1/(list of files, cad)

Other CAD files:
ros2_ws/src/rp1_description/meshes/wheel_front_right.stl
ros2_ws/src/rp1_description/meshes/wheel_rear_right.stl
