robotpicks/rp1/docs/wiring.md

# Wiring notes (MVP: 4 drive wheels, no steering joints)

## Bus

One CAN bus, PC directly to the 4 VESCs -- no bridge MCU (VESC's UAVCAN CAN mode speaks
DroneCAN natively, see `docs/can_id_map.md`). PC side needs a SocketCAN-capable USB-CAN adapter
(e.g. CANable/candleLight running `gs_usb`, or an Innomaker USB2CAN) so it shows up as a plain
Linux `can0` interface -- no custom driver needed. Bring the interface up before launching:
```bash
sudo ip link set can0 type can tq 63 prop-seg 5 phase-seg1 6 phase-seg2 4 sjw 4
sudo ip link set can0 up
```
Same 1 Mbit/s, 75% sample point as a plain `bitrate 1000000` would give you -- these are that
calculation's own tq/prop-seg/phase-seg1/phase-seg2 values, spelled out explicitly so `sjw` can
be set to 4 instead of the default-computed 2. **Use the explicit form, not `bitrate 1000000`
alone**: bench-confirmed 2026-09-15, at the default `sjw 2` this adapter ran ~60% error-class
frames on the bus (FORM errors at the CRC-sequence/EOF tail, `can state` flapping
ACTIVE/ERROR-PASSIVE) because the VESCs' own CAN controllers run at their hardware max SJW (4 tq
-- see `CAN_BTR_SJW(3)` in the bldc repo's `comm/comm_can.c`) while this adapter defaulted to
half that; matching it dropped the error-class fraction to <0.2%, sustained. If the bitrate's
ever changed, re-derive these five values rather than reuse them: set a plain `bitrate <rate>`
first, read back what `ip -details link show can0` computed, then reissue with `sjw` bumped to
whatever max its `gs_usb:` capability line advertises.

**Or make it permanent**: `tools/80-can0-up.rules` (udev rule, confirmed on the bench
2026-08-05, timing updated 2026-09-15) runs those same two commands automatically on every
boot/replug. No automatic bus-off recovery, though -- this bench's gs_usb adapter firmware
doesn't support `restart-ms` (confirmed 2026-08-05, `ip` refuses it: "Device doesn't support
restart from Bus Off") despite supporting berr-reporting (needed for the per-frame FORM/STUFF/
BIT/CRC detail above) -- the two are evidently independent capabilities on this firmware. A
bus-off still needs a manual down/up (or replug) to clear. Install once:
```bash
sudo cp tools/80-can0-up.rules /etc/udev/rules.d/
sudo udevadm control --reload-rules && sudo udevadm trigger
```
This is deliberately a udev rule (`RUN+=`), not a `systemd-networkd` `.network` file, even though
networkd supports a declarative `[CAN] BitRate=` section: udev bring-up doesn't depend on which
network stack (if any) is active/managing the interface, so it works the same whether a given
machine runs networkd, NetworkManager, or neither. If a machine already has its own
networkd/NetworkManager-based CAN config (some benches do -- check `networkctl status can0` /
`nmcli device status`), that's fine to leave in place alongside this rule; both converging on the
same bitrate/up state isn't a conflict worth resolving, just don't rely on one machine's networkd
setup existing on another.

**Adapter firmware**: confirmed on the bench 2026-08-06 for a MKS CANable V1.0 PRO
(`STM32F072C8Tx` per its schematic). If it enumerates as `1d50:606f` with USB strings `bytewerk`
/ "candleLight USB to CAN adapter" rather than `makerbase` / "CANable-MKS gs_usb", it's running
an old/generic candleLight_fw build -- reflash it with the board-specific one below.

Use the **`CANable_MKS` target from candleLight_fw v2.1**, not the `canable` target from the
v2.0 release archive: `canable` is an F042 target (the original CANable/CANtact design, a
different chip) that happens to run on this board's F072 but isn't actually correct for it;
`CANable_MKS` (F072-specific, matching this board) only exists as of v2.1, which has no
GitHub Release/prebuilt binary -- it must be built from source:
```bash
git clone --recurse-submodules https://github.com/candle-usb/candleLight_fw.git
cd candleLight_fw && git checkout v2.1
mkdir build && cd build
# TOOLCHAIN_BIN_DIR: any arm-none-eabi-gcc works, e.g. bldc/tools/gcc-arm-none-eabi-7-2018-q2-update/bin
# (already vendored in this repo tree) or the apt gcc-arm-none-eabi package -- see toolchain note below.
cmake -DCMAKE_TOOLCHAIN_FILE=../cmake/gcc-arm-none-eabi-8-2019-q3-update.cmake \
      -DCMAKE_BUILD_TYPE=Release -DTOOLCHAIN_BIN_DIR=<arm-none-eabi-gcc bin dir> ..
make CANable_MKS_fw   # -> build/CANable_MKS_fw.bin
```
**Toolchain note (confirmed on the bench 2026-08-06)**: Ubuntu's `gcc-arm-none-eabi` apt
package fails with `cannot read spec file 'nano.specs'` -- `nano.specs` is installed by its
`libnewlib-arm-none-eabi` dependency, but under `/usr/lib/arm-none-eabi/newlib/`, which isn't in
gcc's own spec search path (`arm-none-eabi-gcc -print-search-dirs` doesn't list it). Fix once,
system-wide, with a symlink into the directory gcc actually searches (adjust the `14.2.1` path
component to match `arm-none-eabi-gcc -dumpversion` if it differs):
```bash
sudo ln -s /usr/lib/arm-none-eabi/newlib/nano.specs /usr/lib/gcc/arm-none-eabi/14.2.1/nano.specs
```
Without this fix, the vendored `bldc/tools/gcc-arm-none-eabi-7-2018-q2-update/` toolchain works
unmodified (used instead of the apt package the first time this was built, before the symlink
fix above was found).

Flash via USB-DFU (needs `dfu-util`):
```bash
# Unplug, bridge the J5 (BOOT) jumper, plug back in -- lsusb should now show
# 0483:df11 STMicroelectronics STM Device in DFU Mode instead of 1d50:606f.
sudo dfu-util -d 0483:df11 -c 1 -i 0 -a 0 -s 0x08000000:leave -D CANable_MKS_fw.bin
# Then remove the J5 jumper and replug -- back to 1d50:606f in normal (non-DFU) mode.
```
J2 (4-pin: 3.3V/SWCLK/GND/SWDIO) is an alternative SWD flashing/debug path if a probe is
available, bypassing USB-DFU entirely. J4 (unpopulated by default) bridges a 120 ohm
termination resistor across CAN_H/CAN_L -- separate from the bus-level termination below.

Terminate the bus with 120 ohm resistors at each end per standard CAN wiring practice.

## VESC configuration (one-off, not part of the runtime path)

Each VESC is configured directly over its own USB link using VESC Tool: CAN mode =
**VESC+UAVCAN** (not plain UAVCAN -- see `docs/can_id_map.md` for why), CAN ID (doubles as the
DroneCAN node ID in this mode) + `esc_index` (see `docs/can_id_map.md`), motor/FOC parameters,
and current/duty limits. This is a bench/setup-time activity -- the runtime control path never
talks to VESC Tool.

`vesc_tool` also has a headless CLI mode, useful for scripting this instead of using the GUI:
```bash
vesc_tool --vescPort /dev/ttyACM0 --getAppConf app_conf.xml   # read current app config
vesc_tool --vescPort /dev/ttyACM0 --setAppConf app_conf.xml   # write it back after editing
```
The CAN mode/node ID/esc_index fields are part of the app configuration XML.

## Controller

Xbox Series X controller. **Recommended default: wired USB-C, not Bluetooth.** Over Bluetooth
it pairs as BLE HID (`hid_microsoft` driver, shows up via `bluetoothctl` rather than `xpad`),
which on Ubuntu is prone to repeated connect/disconnect flapping (`joy_node` log alternating
"Opened joystick" / "Unable to open ...") even at good signal strength -- a known Linux BT/Xbox
issue, not a range problem. Wired USB avoids it entirely (and switches to the more stable
`xpad` driver), which matters here since this is a robot control input, not just a games
controller. If Bluetooth must be used, try `options bluetooth disable_ertm=1` in
`/etc/modprobe.d/` first (the most commonly effective fix for this specific symptom) and check
USB autosuspend isn't powering down the BT adapter (`/sys/bus/usb/devices/*/power/control`).

**Correction, confirmed on the bench 2026-08-05**: this box has the third-party `xpadneo`
driver installed, not stock `hid_microsoft` -- paired/trusted/connected via `bluetoothctl`
(`pair`/`trust`/`connect`), it came up as `/dev/input/js0` bound to `hid_xpadneo`
(`lsmod`/`/proc/bus/input/devices`), not `hid_microsoft` as assumed above. `xpadneo` is a
known-more-stable BLE HID driver for Xbox pads specifically written to avoid this flapping
issue, so it may not actually apply on this machine -- not independently re-tested for
flapping under long use, but the driver mismatch alone is worth knowing before chasing the
`hid_microsoft` fixes above on this specific box.

Verify it's seen as a joystick device and check axis/button numbering before trusting the
defaults in `rp1_teleop/config/joy_xbox_series_x.yaml`:

```bash
ros2 run joy joy_node    # then, in another terminal:
ros2 topic echo /joy     # wiggle each stick / press each button, note the indices
# or, outside ROS2:
jstest /dev/input/js0
```

## RC radio (ExpressLRS / CRSF) -- alternative to the Xbox pad

An ExpressLRS receiver can drive the robot instead of the Xbox controller. `rp1_elrs`'s
`elrs_node` reads the receiver's **CRSF** stream over a UART and republishes it as `/joy`, so the
same `rp1_teleop` mapping/deadman applies (see `rp1_elrs/config/joy_elrs.yaml`). It also pushes
battery telemetry (from `/wheel_feedback`) back over the link to the handset.

Wiring / setup:

- Put the receiver in **CRSF serial** mode (its default), *not* MAVLink mode (that's a separate,
  not-yet-built Phase-2 path). Default baud is **420000**.
- Connect the RX UART to the PC. Simplest is a 3V3 USB-UART adapter: adapter **RX <- RX TX pad**
  (channels), adapter **TX -> RX RX pad** (telemetry back to the handset), plus GND and 5V.
  On a Pi you can instead use a header UART (`/dev/ttyAMA0`) with the console disabled.
- Set `serial_port` (default `/dev/ttyUSB0`) in `rp1_elrs/config/rp1_elrs.yaml` (or the
  `elrs_node` override in `rp1_bringup/config/rp1_mvp.yaml`).
- CRSF is a half-duplex protocol; on a proper full-duplex two-wire adapter hookup telemetry
  writes are fine. On a true single-wire hookup, telemetry timing collisions are possible --
  `elrs_node` writes telemetry on a simple timer and does not yet arbitrate RX telemetry slots.

Verify the channel/switch mapping before trusting the defaults in `rp1_elrs/config/rp1_elrs.yaml`
(`axis_channels`, `deadman_channel`) -- they assume AETR channel order and a 2-position arm
switch, which is TX-dependent:

```bash
ros2 launch rp1_elrs elrs_teleop.launch.py    # elrs_node + rp1_teleop, no joy_node
# then watch /joy (small rclpy subscriber preferred; see CLAUDE.md on echo flakiness) and move
# each stick / flip the arm switch -- confirm axes move and button 4 toggles with the switch.
```

To exercise the parser without a receiver, make a virtual serial pair
(`socat -d -d pty,raw,echo=0 pty,raw,echo=0`), point `serial_port` at one pty, and write canned
`RC_CHANNELS_PACKED` bytes into the other. Or run `elrs_node` with `require_serial:=false` to
dry-run the telemetry side (frames are logged, no port opened) -- the analogue of the DroneCAN
bridge's `require_can:=false`.

## Testing without hardware

Two levels, from least to most CAN-realistic:

1. `ros2 launch rp1_bringup rp1_mvp.launch.py use_mock:=true` -- swaps the DroneCAN hardware
   component for `mock_components/GenericSystem`,
   a pure-ROS2 node with no CAN involved at all. Use this to check the ROS2 graph itself
   (teleop -> control -> odometry/TF) with `ros2 topic echo` or rviz2.
2. `simulation/` (bonus) -- a virtual CAN interface (`vcan0`) plus a script that pretends to be
   the 4 VESCs, so the real hardware component can be exercised (DroneCAN wire format and
   all) with zero physical hardware. See `simulation/README.md`.

## Bring-up order

1. Configure each VESC's UAVCAN settings on the bench (one at a time, confirm with VESC Tool
   before wiring it into the shared bus) and fill in `docs/can_id_map.md`.
2. One VESC + one motor on the real `can0` bus, confirm a synthetic RawCommand (or the real
   ROS2 pipeline) spins it correctly.
3. Repeat for all 4 wheels.
4. Bring up the full ROS2 pipeline (`ros2 launch rp1_bringup rp1_mvp.launch.py`), wheels off
   the ground first, with the deadman button held. **Resolved 2026-08-06 for 3 of 4 wheels**:
   wheels initially stayed still here even with step 2-3 passing and `esc.RPMCommand` confirmed
   reaching the bus with correct values -- each drive VESC's "Minimum ERPM" (`s_pid_min_erpm`,
   default 900) was above this robot's actual commanded ERPM range, so the firmware's speed-PID
   never left its disabled state. Fixed by lowering it (VESC Tool -> Motor Settings -> FOC ->
   Speed Controller) on all 4 drive VESCs -- see `docs/can_id_map.md`'s VESC UAVCAN configuration
   section for the full writeup. Front-left, front-right and rear-right now spin correctly under
   the full pipeline; **rear-left (esc_index 3) is still an open issue**, currently suspected to
   be a stale FOC motor detection from when a phase connector on that unit was loose (see
   `can_id_map.md`'s open-issue note) -- not yet resolved.
5. On-ground drive test, Xbox pad pipeline first: verify the controller per the "Controller"
   section above (`joy_node` + `jstest`/`ros2 topic echo /joy`) before trusting the deadman/axis
   mapping, then run the full stack with `ros2 launch rp1_bringup rp1_mvp.launch.py` (the Xbox
   pipeline, not the `_elrs` variant) with low speed limits first (cap the teleop
   `scale_linear`/`scale_angular` in `rp1_teleop`'s config -- there is no separate
   max_wheel_speed knob any more). Try the ELRS radio pipeline as a follow-up once the Xbox path
   is proven out.
