robotpicks/rp1/ros2_ws/src/rp1_description/urdf/rp1_drive.urdf

<?xml version="1.0"?>
<!--
  rp1 MVP description: the 4 drive wheels, skid-steer, no steering joints.

  GEOMETRY IS FROM THE CAD, NOT YET CONFIRMED BY MECHANICAL DESIGN. track width ~1.139 m,
  wheelbase ~0.8 m, wheel radius ~0.215 m come from tools/export_urdf_meshes.py in the
  rp1-mechanical submodule, measured directly off the ZLLG16ASM800 hub-motor placements in
  UZM.08.13.300.00.FCStd -- docs/mechanical_request.{pdf,xlsx}'s §3.1/§3.3.2 tables are still
  blank (nobody from mechanical design has filled them in), so this is the first real number,
  not a placeholder round number, but it is CAD-nominal, not a measured/loaded rolling radius.
  The chassis has no geometric front-back or left-right distinction (checked: controls are
  mounted symmetrically left/right, payload bay is centred) -- FRONT_IS_POSITIVE_CAD_Z /
  LEFT_IS_POSITIVE_CAD_X in that script are a confirmed (2026-07-28) but arbitrary convention,
  not something derived from the physical robot. Update here AND in
  rp1_bringup/config/rp1_controllers.yaml (diff_drive_controller takes wheel_separation and
  wheel_radius as its own parameters, it does not read them from this file).

  base_link is at the ground projection of the geometric centre of the four wheel contact
  patches, X forward / Y left / Z up (REP-103). The CAD is modelled +Y-up (confirmed by
  measuring the actual hub-motor positions, not assumed) -- export_urdf_meshes.py's CAD_TO_ROS
  rotation accounts for that; §1 of the mechanical request still asks mechanical design to
  confirm the frame convention independently.

  Steering actuators are deliberately NOT in this description: the same VescDroneCanSystem component
  handles them (see rp1_steering.urdf), but including them here would broadcast an
  actuator.ArrayCommand every cycle with whatever the unclaimed command interface holds, and
  firmware ArrayCommand support is on a non-mainline branch (see docs/can_id_map.md). Add them
  when the swerve controller exists.

  Meshes and the joint <origin> numbers below come from the rp1-mechanical FreeCAD assembly via
  tools/export_urdf_meshes.py in that submodule -- re-run it and update both after a CAD change.
-->
<robot name="rp1">
  <link name="base_link">
    <visual>
      <geometry>
        <mesh filename="package://rp1_description/meshes/chassis.stl"/>
      </geometry>
    </visual>
    <!-- Box approximation, not the detailed mesh: a 40MB concave compound of hundreds of
         parts (suspension, gearboxes, batteries...) is a bad collision/physics shape --
         slow at best, unstable at worst. Sized from the CAD's own chassis bounding box
         (tools/export_urdf_meshes.py), not measured/tuned. -->
    <collision>
      <origin xyz="-0.007 0 0.740" rpy="0 0 0"/>
      <geometry>
        <box size="1.016 1.512 1.110"/>
      </geometry>
    </collision>
    <!-- GUESSED mass/inertia, not measured or CAD-derived -- the CAD has no material/density
         assigned to any part, so there's no real mass to read off it. Needed only because
         Gazebo's URDF->SDF conversion silently drops any link with no <inertial> block, and
         drops everything downstream of it too (base_link is root, so that meant all 4 wheels
         vanished). 300kg is an order-of-magnitude guess for a steel-framed ag-robot chassis
         carrying 4x 12V 135Ah batteries (~35-40kg each); inertia is a solid-box approximation
         using the collision box dimensions above. Replace with real weighed/measured values
         before trusting simulated dynamics (acceleration, tipping, torque) for anything. -->
    <inertial>
      <origin xyz="-0.007 0 0.740" rpy="0 0 0"/>
      <mass value="300.0"/>
      <inertia ixx="87.95" ixy="0" ixz="0" iyy="56.61" iyz="0" izz="82.96"/>
    </inertial>
  </link>

  <!-- Drive wheels. esc_index is the value set on that VESC's "UAVCAN ESC index" field in VESC
       Tool; it must match docs/can_id_map.md's wheel index table. -->
  <link name="wheel_front_left_link">
    <visual>
      <geometry>
        <mesh filename="package://rp1_description/meshes/wheel_front_left.stl"/>
      </geometry>
    </visual>
    <!-- Cylinder approximation (radius/width from the CAD wheel bbox), not the detailed
         hub-motor mesh -- see base_link's collision comment. rpy rotates the cylinder's
         local Z (its default axis) onto the wheel's spin axis, Y. -->
    <collision>
      <origin xyz="0 0 0" rpy="1.5708 0 0"/>
      <geometry>
        <cylinder radius="0.2154" length="0.1549"/>
      </geometry>
    </collision>
    <!-- GUESSED mass/inertia -- see base_link's inertial comment; same reasoning, same
         caveats. 15kg is an order-of-magnitude guess for a ~430mm hub-motor wheel unit;
         inertia is a solid-cylinder approximation about the spin axis (Y, so no rotation
         needed here unlike the collision cylinder above). -->
    <inertial>
      <mass value="15.0"/>
      <inertia ixx="0.204034" ixy="0" ixz="0" iyy="0.3481" iyz="0" izz="0.204034"/>
    </inertial>
  </link>
  <joint name="drive_front_left" type="continuous">
    <parent link="base_link"/>
    <child link="wheel_front_left_link"/>
    <origin xyz="0.399903 0.569306 0.215396" rpy="0 0 0"/>
    <axis xyz="0 1 0"/>
  </joint>

  <link name="wheel_front_right_link">
    <visual>
      <geometry>
        <mesh filename="package://rp1_description/meshes/wheel_front_right.stl"/>
      </geometry>
    </visual>
    <collision>
      <origin xyz="0 0 0" rpy="1.5708 0 0"/>
      <geometry>
        <cylinder radius="0.2154" length="0.1549"/>
      </geometry>
    </collision>
    <!-- GUESSED mass/inertia -- see base_link's inertial comment. -->
    <inertial>
      <mass value="15.0"/>
      <inertia ixx="0.204034" ixy="0" ixz="0" iyy="0.3481" iyz="0" izz="0.204034"/>
    </inertial>
  </link>
  <joint name="drive_front_right" type="continuous">
    <parent link="base_link"/>
    <child link="wheel_front_right_link"/>
    <origin xyz="0.400097 -0.569306 0.215396" rpy="0 0 0"/>
    <axis xyz="0 1 0"/>
  </joint>

  <link name="wheel_rear_left_link">
    <visual>
      <geometry>
        <mesh filename="package://rp1_description/meshes/wheel_rear_left.stl"/>
      </geometry>
    </visual>
    <collision>
      <origin xyz="0 0 0" rpy="1.5708 0 0"/>
      <geometry>
        <cylinder radius="0.2154" length="0.1549"/>
      </geometry>
    </collision>
    <!-- GUESSED mass/inertia -- see base_link's inertial comment. -->
    <inertial>
      <mass value="15.0"/>
      <inertia ixx="0.204034" ixy="0" ixz="0" iyy="0.3481" iyz="0" izz="0.204034"/>
    </inertial>
  </link>
  <joint name="drive_rear_left" type="continuous">
    <parent link="base_link"/>
    <child link="wheel_rear_left_link"/>
    <origin xyz="-0.400097 0.569306 0.215396" rpy="0 0 0"/>
    <axis xyz="0 1 0"/>
  </joint>

  <link name="wheel_rear_right_link">
    <visual>
      <geometry>
        <mesh filename="package://rp1_description/meshes/wheel_rear_right.stl"/>
      </geometry>
    </visual>
    <collision>
      <origin xyz="0 0 0" rpy="1.5708 0 0"/>
      <geometry>
        <cylinder radius="0.2154" length="0.1549"/>
      </geometry>
    </collision>
    <!-- GUESSED mass/inertia -- see base_link's inertial comment. -->
    <inertial>
      <mass value="15.0"/>
      <inertia ixx="0.204034" ixy="0" ixz="0" iyy="0.3481" iyz="0" izz="0.204034"/>
    </inertial>
  </link>
  <joint name="drive_rear_right" type="continuous">
    <parent link="base_link"/>
    <child link="wheel_rear_right_link"/>
    <origin xyz="-0.399903 -0.569306 0.215396" rpy="0 0 0"/>
    <axis xyz="0 1 0"/>
  </joint>

  <ros2_control name="rp1_drive" type="system">
    <hardware>
      <plugin>vesc_dronecan_driver/VescDroneCanSystem</plugin>
      <param name="can_iface">can0</param>
      <param name="node_id">42</param>
      <!-- Motor revolutions per wheel revolution. PLACEHOLDER: §3.4.5 of the mechanical
           request. 1.0 means direct drive. -->
      <param name="gear_ratio">1.0</param>
      <!-- si_motor_poles / 2 from the VESC motor configuration. Corrected 2026-09-22: the
           2026-09-14 note below had this backwards -- "20" is the pole COUNT typed into VESC
           Tool's FOC wizard "Motor Poles" field (confirmed live via si_motor_poles=20 read off
           the bench VESC), i.e. 20 poles / 10 pole pairs, not 20 pole pairs/40 poles as that
           commit claimed. The wrong 20.0 made the driver overcommand ERPM to 2x the intended
           value for a given wheel speed -- the robot would move at ~2x the speed cmd_vel called
           for. (2026-09-14 context, still correct in every other respect: the original 7.0
           placeholder undercommanded ERPM to ~35% of intended, close enough to s_pid_min_erpm to
           cause intermittent PID engage/disengage jitter too.) -->
      <param name="motor_pole_pairs">10.0</param>
      <!-- VESC firmware is asymmetric about RPM units on the wire: esc.Status.rpm is divided by
           pole pairs before sending (mechanical RPM), but handle_esc_rpm_command() feeds
           RPMCommand straight into mc_interface_set_pid_speed() as ERPM. true compensates for
           that. Set false only after the firmware fork scales the command side too. -->
      <param name="command_rpm_is_erpm">true</param>
      <!-- Safety watchdog (2026-09-14): if ANY configured drive esc_index hasn't sent an
           esc.Status within this many seconds -- never showed up on the bus at all, or dropped
           off mid-run -- the driver commands zero RPM to ALL drive wheels, not just the missing
           one, until every esc_index is heard from again. See vesc_dronecan_ros's README. -->
      <param name="esc_timeout_sec">0.5</param>
    </hardware>

    <!-- esc_index assignments below reflect the 2026-09-14 90-degree chassis reorientation
         (old right side is now front) -- see docs/can_id_map.md. The esc-to-motor wiring itself
         did not change; only which URDF corner each esc now sits at. -->
    <joint name="drive_front_left">
      <param name="esc_index">2</param>
      <command_interface name="velocity"/>
      <state_interface name="velocity"/>
      <state_interface name="position"/>
    </joint>
    <joint name="drive_front_right">
      <param name="esc_index">4</param>
      <command_interface name="velocity"/>
      <state_interface name="velocity"/>
      <state_interface name="position"/>
    </joint>
    <joint name="drive_rear_left">
      <param name="esc_index">1</param>
      <command_interface name="velocity"/>
      <state_interface name="velocity"/>
      <state_interface name="position"/>
    </joint>
    <joint name="drive_rear_right">
      <param name="esc_index">3</param>
      <command_interface name="velocity"/>
      <state_interface name="velocity"/>
      <state_interface name="position"/>
    </joint>

    <!-- Per-ESC telemetry from the same esc.Status messages. Reaches /dynamic_joint_states via
         joint_state_broadcaster; rp1_elrs turns it into the handset's BatteryState. -->
    <gpio name="esc_front_left">
      <param name="esc_index">2</param>
      <state_interface name="voltage"/>
      <state_interface name="current"/>
      <state_interface name="temperature"/>
    </gpio>
    <gpio name="esc_front_right">
      <param name="esc_index">4</param>
      <state_interface name="voltage"/>
      <state_interface name="current"/>
      <state_interface name="temperature"/>
    </gpio>
    <gpio name="esc_rear_left">
      <param name="esc_index">1</param>
      <state_interface name="voltage"/>
      <state_interface name="current"/>
      <state_interface name="temperature"/>
    </gpio>
    <gpio name="esc_rear_right">
      <param name="esc_index">3</param>
      <state_interface name="voltage"/>
      <state_interface name="current"/>
      <state_interface name="temperature"/>
    </gpio>
  </ros2_control>
</robot>
