robotpicks/rp1/ros2_ws/src/rp1_bringup/config/rp1_swerve_controllers.yaml

# controller_manager + controller configuration for rp1_swerve.urdf (4 drive + 4 steering).
#
# Geometry (half_wheelbase/half_track) mirrors rp1_swerve.urdf's steering-axis origins, which
# come from rp1-specs/mechanical_spec.md's CAD table -- keep these in step with that URDF by
# hand, same caveat rp1_controllers.yaml already carries for diff_drive_controller's
# wheel_separation/wheel_radius.
controller_manager:
  ros__parameters:
    update_rate: 50  # Hz -- matches rp1_controllers.yaml's diff_drive_controller rate

    joint_state_broadcaster:
      type: joint_state_broadcaster/JointStateBroadcaster

    rp1_swerve_controller:
      type: rp1_swerve_controller/RP1SwerveController

joint_state_broadcaster:
  ros__parameters:
    # Required for the per-ESC/steering-sensor <gpio> telemetry to reach /dynamic_joint_states --
    # see rp1_controllers.yaml's comment for why both of these default to suppressing it.
    publish_dynamic_joint_states: true
    use_urdf_to_filter: false

rp1_swerve_controller:
  ros__parameters:
    drive_joints:
      - drive_front_left
      - drive_front_right
      - drive_rear_left
      - drive_rear_right
    steering_joints:
      - steering_front_left
      - steering_front_right
      - steering_rear_left
      - steering_rear_right
    half_wheelbase: 0.4
    half_track: 0.64
    # Which 2 corners free-steer in TWO_WHEEL mode -- any 2 of the 4, not fixed to a front/rear
    # pair. Default is the front pair (a conventional front-steered vehicle).
    two_wheel_steered_corners:
      - front_left
      - front_right
    # Rolling radius for converting drive-joint angular velocity state into linear speed for
    # odometry -- matches rp1_drive.urdf's wheel collision cylinder radius.
    wheel_radius: 0.2154
    # Staleness watchdog on ~/cmd_vel, seconds -- same role (and value) as diff_drive_controller's
    # cmd_vel_timeout in rp1_controllers.yaml: a publisher going quiet zeroes the drive wheels
    # (steering holds its angle) instead of latching the last twist forever.
    cmd_vel_timeout: 0.5
    odom_frame_id: odom
    base_frame_id: base_link
    enable_odom_tf: true
