robotpicks/rp1/simulation/sim_vesc_node.py

#!/usr/bin/env python3
"""Standalone DroneCAN simulator: pretends to be the 4 VESC UAVCAN ESC nodes on a CAN bus.

No ROS2 dependency -- the real VESCs don't have one either, they just speak DroneCAN on the
wire. Point this at a virtual CAN interface (see README.md in this directory for `vcan0` setup)
and it'll consume `uavcan.equipment.esc.RPMCommand` and reply with `uavcan.equipment.esc.Status`,
so vesc_dronecan_driver can be run for real -- actual DroneCAN framing, against a virtual bus
-- with zero physical hardware.

It reproduces the VESC firmware's RPM unit asymmetry deliberately, because that is the part of
the stack most likely to be wrong and the loopback check exists to catch it:

  RPMCommand in  -- ERPM. handle_esc_rpm_command() feeds the value straight to
                    mc_interface_set_pid_speed() with no pole-pair scaling.
  Status.rpm out -- mechanical RPM. sendEscStatus() divides by pole pairs before transmitting.

So a rounded trip through here only lands back where it started if the caller's motor_pole_pairs
matches --pole-pairs. Both default to 10 (20-pole motor / 10 pole pairs, corrected 2026-09-22 --
see rp1_drive.urdf's motor_pole_pairs comment).

Wheel dynamics are a simple rate-limited approach to the target, not a physical motor model --
good enough to see plausible-looking, moving telemetry.
"""

import argparse
import time

import dronecan

NUM_WHEELS = 4
MAX_RPM = 3000.0            # mechanical, a clamp on what the simulated motor can reach
RPM_SLEW_PER_SEC = 4000.0
NOMINAL_VOLTAGE = 24.0
ROOM_TEMPERATURE_KELVIN = 298.15  # DroneCAN temperature fields are Kelvin


def _force_native_socketcan_driver() -> None:
    """dronecan.driver.make_driver() always prefers its python-can-backed PythonCAN driver over
    the native SocketCAN one whenever the `can` package is merely importable (see
    dronecan/driver/__init__.py's make_driver(): `elif PythonCAN is not None: return
    PythonCAN(...)` runs before the SocketCAN fallback, and PythonCAN is non-None as long as
    `import can` succeeded, regardless of which python-can version). Confirmed broken against
    python-can 4.6.1 -- not just the flush_tx_buffer() incompatibility this function used to
    patch around (python-can >=4's BusABC no longer implements it), but something deeper:
    node.broadcast() silently queues a frame that never reaches the bus at all, and node.spin()
    then hangs indefinitely rather than timing out. Forcing dronecan.driver.PythonCAN to None
    here makes make_driver() fall through to the native SocketCAN class instead (Linux-only, no
    python-can involved), which was confirmed to actually place frames on the bus and complete
    spin() normally. Must run before dronecan.make_node() below.
    """
    import dronecan.driver
    dronecan.driver.PythonCAN = None


class SimulatedWheel:

    def __init__(self, pole_pairs: float):
        self._pole_pairs = pole_pairs
        self.target_rpm = 0.0   # mechanical
        self.rpm = 0.0          # mechanical

    def set_command(self, erpm: int) -> None:
        """RPMCommand carries ERPM (see the module docstring); the rotor turns pole_pairs slower."""
        mechanical = erpm / self._pole_pairs
        self.target_rpm = max(-MAX_RPM, min(MAX_RPM, mechanical))

    def step(self, dt: float) -> None:
        delta = self.target_rpm - self.rpm
        max_step = RPM_SLEW_PER_SEC * dt
        if abs(delta) <= max_step:
            self.rpm = self.target_rpm
        else:
            self.rpm += max_step if delta > 0 else -max_step


def main():
    parser = argparse.ArgumentParser(description=__doc__)
    parser.add_argument('--iface', default='vcan0', help='SocketCAN interface (default: vcan0)')
    parser.add_argument('--node-id', type=int, default=10, help='this simulator\'s DroneCAN node ID')
    parser.add_argument('--status-rate-hz', type=float, default=10.0)
    parser.add_argument('--pole-pairs', type=float, default=10.0,
                        help="motor pole pairs, for the ERPM<->mechanical conversion; must match "
                             "rp1_drive.urdf's motor_pole_pairs (default: 10)")
    args = parser.parse_args()

    # Keyed by esc_index as it appears in RPMCommand: the URDF assigns the
    # indices (currently 1..4), and hard-coding a 0-based range here silently
    # dropped any wheel whose index fell outside it (rear_right at 4 -- found
    # by CI's loopback check reading 0.000 rad/s on exactly that joint).
    wheels = {}
    _force_native_socketcan_driver()
    # bitrate is accepted for API compatibility but ignored by the native SocketCAN driver (the
    # interface's real bitrate is set via `ip link`).
    node = dronecan.make_node(args.iface, node_id=args.node_id, bitrate=1000000)

    def on_rpm_command(event):
        for esc_index, erpm in enumerate(event.message.rpm):
            if len(wheels) < NUM_WHEELS and esc_index not in wheels and erpm != 0:
                wheels[esc_index] = SimulatedWheel(args.pole_pairs)
            if esc_index in wheels:
                wheels[esc_index].set_command(erpm)

    node.add_handler(dronecan.uavcan.equipment.esc.RPMCommand, on_rpm_command)

    last_step_time = [time.monotonic()]

    def broadcast_status():
        now = time.monotonic()
        dt = now - last_step_time[0]
        last_step_time[0] = now
        for esc_index, wheel in wheels.items():
            wheel.step(dt)
            node.broadcast(dronecan.uavcan.equipment.esc.Status(
                esc_index=esc_index,
                rpm=int(wheel.rpm),
                voltage=NOMINAL_VOLTAGE,
                current=abs(wheel.rpm) / MAX_RPM * 10.0,
                temperature=ROOM_TEMPERATURE_KELVIN,
            ))

    # Deliberately not using node.periodic(): verified experimentally that its callback never
    # actually fires with this dronecan version (sched.scheduler.run(blocking=False) interaction
    # issue) -- manual elapsed-time tracking in the main loop instead.
    status_period = 1.0 / args.status_rate_hz
    next_status_time = time.monotonic() + status_period

    print('sim_vesc_node: simulating %d VESCs on %s (node_id=%d)'
          % (NUM_WHEELS, args.iface, args.node_id))
    try:
        while True:
            try:
                # timeout=0 deliberately: this dronecan/python-can version pair multiplies any
                # nonzero timeout by 1000 before handing it to python-can's recv() (which wants
                # seconds, not ms), so e.g. timeout=0.1 would block for ~100s instead of 100ms.
                node.spin(timeout=0)
            except Exception as exc:  # noqa: BLE001 - a bad received frame must not kill the sim
                print('sim_vesc_node: spin error, ignoring: %s' % exc)

            now = time.monotonic()
            if now >= next_status_time:
                next_status_time = now + status_period
                broadcast_status()

            time.sleep(0.01)
    except KeyboardInterrupt:
        pass


if __name__ == '__main__':
    main()
