robotpicks/rp1/(commit log)

2026-07-16 Scaffold rp1 MVP: 4 diff-wheel base with ROS2 + DroneCAN + Xbox teleop
    Adds the ROS2 packages for the teleop -> kinematics -> DroneCAN bridge
    pipeline (rp1_teleop, rp1_control, rp1_dronecan_bridge, rp1_msgs,
    rp1_bringup), plus docs and a firmware README for the still-unbuilt
    DroneCAN<->VESC-CAN bridge MCU. Steering joints are intentionally out
    of scope for this pass; see docs/can_id_map.md for the extension plan.
2026-07-16 Drop bridge MCU firmware; add rp1_sim + DroneCAN vcan simulator
    VESC firmware has a built-in UAVCAN/DroneCAN CAN mode, so the planned
    custom bridge MCU firmware is unnecessary -- the PC talks DroneCAN
    directly to the 4 VESCs over one CAN bus. Removed
    firmware/bridge_node/ and updated docs/README/CLAUDE.md accordingly.
    Adds rp1_sim, a pure-ROS2 stand-in for rp1_dronecan_bridge (no CAN at
    all) that simulates wheel dynamics, odometry, and TF -- the primary
    way to validate the ROS2 architecture with zero hardware, wired into
    rp1_bringup/launch/rp1_mvp_sim.launch.py.
    Adds simulation/sim_vesc_node.py, a bonus standalone DroneCAN script
    that pretends to be the 4 VESCs on a vcan interface, for exe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
2026-07-16 Document control hierarchy, add rviz sim launch, recommend wired Xbox
    README: explain the layered control hierarchy (input -> kinematics ->
    transport -> actuator) for both the implemented drive wheels
    (velocity-controlled) and the planned steering joints
    (position-controlled, open actuator-type decision) sharing the same
    pipeline. Adds a roadmap section for the steering joints extension,
    an ExpressLRS-based RC controller as an alternative input, and an
    OpenIPC camera for vision -- none designed yet, just noted.
    Adds rp1_mvp_sim_rviz.launch.py (rp1_mvp_sim.launch.py + rviz2,
    pre-configured to watch /odom and TF), verified live end-to-end.
    docs/wiring.md: recommend wired USB-C for the Xbox S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
2026-07-16 Document VESC+UAVCAN CAN mode (firmware 7.00)
    Firmware 7.00 splits UAVCAN CAN mode into plain UAVCAN and
    VESC+UAVCAN (CAN_MODE_VESC_UAVCAN); the latter is required so VESC's
    native CAN protocol keeps working alongside DroneCAN on the shared
    bus. Also clarifies that the DroneCAN node ID is the VESC's normal
    CAN ID (controller_id) field, not a separate UAVCAN-only ID, and
    confirms the RawCommand duty scaling against the firmware 7.00
    source (/home/user/dev/bldc).
2026-07-17 Add rp1_hardware_interface: ros2_control bridge for steering actuators
    Bridges the gap between ros2_control (position command/state
    interfaces) and DroneCAN: a hardware_interface::SystemInterface plugin
    that talks uavcan.equipment.actuator.{ArrayCommand,Status} directly
    over SocketCAN, using a vendored copy of the same libcanard codec the
    VESC firmware uses (bldc branch add-actuator-arraycommand), ported to
    64-bit with two documented fixes (a pointer-size-dependent memory
    layout assert, and a swapByteOrder declaration mismatch) rather than
    routing through rp1_dronecan_bridge's Python dronecan/python-can stack.
    Each joint's DroneCAN actuator_id is set via a URDF <ros2_control>
    param, matchin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
    [controller_manager.yaml, rp1_steering.urdf]
2026-07-17 Wire up real controllers and fix concurrent-spawner hang
    Adds joint_state_broadcaster and a
    position_controllers/JointGroupPositionController
    (steering_position_controller) claiming the two steering joints'
    position command interfaces -- the actual closed-loop-wiring test.
    Spawning both controllers concurrently (two Node entries with no
    ordering) hung controller_manager's services entirely (list_controllers,
    configure_controller never returning, and inconsistently even the
    'Initialize hardware' step itself). Root cause: controller_manager's
    service handling runs on the same thread as its real-time update loop
    (ros-controls/ros2_control#2808), and without CAP_SYS_NICE in this
    sandbox (RT sch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
    [controller_manager.yaml]
2026-07-17 Document steering convention; add swerve simulation (both tiers)
    docs/can_id_map.md: documents the steering actuator_id = drive wheel
    index + 4 convention and uavcan.equipment.actuator.ArrayCommand/Status
    usage that rp1_hardware_interface and the bldc add-actuator-arraycommand
    branch already implement.
    Adds swerve-equivalent simulation at both existing tiers:
    - rp1_sim: new swerve_sim_node.py, alongside the existing skid-steer
    sim_bridge_node.py (left untouched). Subscribes WheelCommand +
    new SteeringCommand, does full swerve forward kinematics
    (least-squares body-twist fit from 4 wheels' speed+angle, since
    there's no swerve inverse-kinematics controller in rp1_control yet
    to pro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
2026-07-17 Fix bridge_node log spam when steering actuators share the CAN bus
    Steering actuators (nodes 5/6, add-actuator-arraycommand firmware) broadcasting
    alongside the drive VESCs made bridge_node's spin() raise "Unrecognised message
    type ID" at 100+/sec: actuator.Status (DTID 1011) was never recognised since
    this bridge only ever referenced esc.* messages, and the firmware separately
    broadcasts a high-rate custom message (DTID 20601) with no public DSDL at all.
    Register actuator.Status so its DTID gets known, and stop logging the
    DTID-20601 case as an ERROR since it can't be decoded and is expected noise.
2026-07-24 Add rp1_elrs: ExpressLRS (CRSF) UART teleop + handset telemetry
    New optional RC input alongside the Xbox pad: an ExpressLRS receiver's CRSF
    stream over a UART, republished as sensor_msgs/Joy so rp1_teleop (scaling,
    deadman, staleness) is reused unchanged. Battery telemetry from /wheel_feedback
    is pushed back over the same link to the handset.
    - rp1_elrs/crsf.py: pure, ROS-independent CRSF codec (CRC8/DVB-S2, incremental
    parser with resync, channel pack/unpack, BATTERY_SENSOR builder) + unit test.
    Kept separate so a MAVLink codec can sit beside it (Phase-2 MAVLink-over-ELRS
    seam; only CRSF is implemented now).
    - rp1_elrs/elrs_node.py: mirrors bridge_node.py conventions -- lazy pyserial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
2026-07-25 rp1_elrs: move the CRSF driver out to the generic elrs_driver
    The CRSF codec, RC->Joy node, serial handling and failsafe were rp1-specific
    only by accident -- none of it depends on rp1. They now live in the elrs_ros
    submodule as the robot-agnostic `elrs_driver` package, so rp1_elrs shrinks to
    just the glue:
    - deleted crsf.py, elrs_node.py, test/test_crsf.py, requirements.txt
    (all now in elrs_ros/elrs_driver/, alongside a new links.py + test_links.py)
    - added wheel_feedback_to_battery.py: the one genuinely rp1-specific piece,
    aggregating the 4 VESCs' rp1_msgs/WheelFeedback into the standard
    sensor_msgs/BatteryState that elrs_driver expects for handset telemetry
    - rp1_elrs.y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
2026-07-25 Repair the ELRS bringup path and build against current ROS 2
    Building the workspace against a current ROS 2 (lyrical, with ros2-control)
    turned up four independent breakages, three of them left behind by the commit
    that extracted the CRSF driver into the generic elrs_driver package.
    rp1_mvp_elrs.launch.py still launched `rp1_elrs`'s `elrs_node`, an executable
    that ceased to exist when the driver moved out — so `bringup elrs` could not
    start at all. It now launches `elrs_driver` from the elrs_ros submodule, and
    adds the `wheel_feedback_to_battery` node that the rewrite dropped: without it
    the /wheel_feedback -> /battery -> handset telemetry direction was simply
    absent from the pipeline, si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
2026-07-25 Exit cleanly on SIGINT/SIGTERM across all five nodes
    Every node shared the same main(): spin in a try, destroy_node()/shutdown() in
    the finally, nothing catching rclpy's shutdown exception. So an ordinary stop --
    Ctrl-C, or a launch/systemd supervisor sending SIGTERM -- ended in a traceback
    and exit 1, which anything supervising these nodes reads as a crash.
    Catching ExternalShutdownException alone isn't sufficient: rclpy also races
    itself. If the signal arrives while the executor is building its wait set, the
    context is invalidated underneath it and spin() raises RCLError ("the given
    context is not valid") instead. That path is intermittent -- it hit teleop_node
    on one run and control_node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
2026-07-25 Add a DroneCAN loopback assertion for the vcan simulator
    simulation/ could already put real DroneCAN traffic on a virtual bus, but nothing
    checked the result: you ran sim_vesc_node plus the bridge and eyeballed
    `ros2 topic echo /wheel_feedback`. That is not something CI can gate on.
    check_dronecan_loopback.py drives a known WheelCommand and asserts on the
    WheelFeedback that comes back, so it only passes if the whole path is intact --
    bridge encoding esc.RawCommand, real framing on the wire, sim decoding it, its
    esc.Status replies, and the bridge turning those back into ROS messages.
    Two phases, because "telemetry appears" is a weaker claim than "the robot stops
    when told nothing":
    1. dr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
2026-07-25 Add a bilingual geometry/mass-properties request for mechanical design
    rp1 has no physical description: the kinematics, odometry and simulation run on
    placeholder numbers (track_width 0.5, wheelbase 0.5, wheel_radius 0.1, spread
    across rp1_control, rp1_sim and swerve_sim configs) and rp1_steering.urdf is a
    two-joint skeleton with every joint at the origin.
    docs/mechanical_request.md is the request that replaces them: a fill-in-and-return
    document covering the frame conventions to agree first (REP-103 axes, base_link
    definition, zero pose), the CAD/mesh/mass-property files to export, and the
    per-corner parameter tables -- steering axis positions, scrub radius and caster,
    loaded rolling radiu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
2026-07-25 Add a fill-in workbook alongside the mechanical geometry request
    docs/mechanical_request.xlsx carries the same sections and the same bilingual
    text as the PDF, but is easier to fill in and to read back into the ROS configs.
    Seven sheets: instructions, §1 conventions and §2 files as confirmations with
    dropdowns, §3 scalar parameters, a §3.1/§3.2 per-corner matrix, §4 sensor mounts,
    and §5 process. Only the cream cells are for mechanical design to fill; the
    Source column is a CAD/MEAS dropdown on every parameter row.
    Compound entries from the PDF are split into one row per value so the sheet can
    be parsed straight into the configs -- §3.5.1 into length/width/height, §3.5.5
    into four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
    [mechanical_request.xlsx]
2026-07-26 Move the MVP drive path onto ros2_control
    The drive chain was rp1_teleop -> rp1_control -> rp1_dronecan_bridge, all of it
    hand-written. It is now rp1_teleop -> diff_drive_controller -> the ros2_control
    hardware component. Both old packages are deleted: the skid-steer kinematics, the
    /cmd_vel watchdog and the odometry are stock diff_drive_controller, and the
    DroneCAN encoding moved into read()/write() alongside the steering actuators that
    already lived there. DroneCAN itself is unchanged -- only the process speaking it
    moved, and the drive wheels moved from esc.RawCommand to esc.RPMCommand.
    RPMCommand rather than RawCommand because RawCommand is duty cycle, which cannot
    honestly back a veloc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
    [rp1_controllers.yaml, rp1_drive.urdf, rp1_steering.urdf]
2026-07-26 Tighten the loopback checker's telemetry assertion
    EscTelemetry.voltage starts at 0.0, so requiring only that all four ESC names
    appear on /dynamic_joint_states would still pass if esc.Status stopped decoding --
    the topic would carry four zeros and the check would call it fine. Require a
    finite, positive reading instead.
    Also records why this phase needs the real hardware component rather than
    use_mock:=true: mock_components leaves unclaimed gpio states at NaN, so only
    sim_vesc_node puts an actual pack voltage on the wire.
    [check_dronecan_loopback.py]
2026-07-26 Update the simulation README for the ros2_control drive path
    The bridge this directory drove is gone, so the run instructions and the
    description of what check_dronecan_loopback.py asserts were both stale.
    Also draws the line between the two no-hardware tiers more sharply, since it is
    now easy to reach for the wrong one: use_mock:=true stops at the hardware
    boundary and exercises nothing below rp1_hardware_interface, while this directory
    is specifically what covers that last layer. Records that the scale assertion only
    closes if rp1_drive.urdf's motor_pole_pairs matches sim_vesc_node's --pole-pairs,
    and that the telemetry phase will correctly fail under mock, whose unclaimed gpio
    states sit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
2026-07-26 Move the VESC DroneCAN hardware component out to vesc_dronecan_ros
    None of that component was ever rp1-specific -- the SocketCAN plumbing, the
    vendored libcanard, the esc/actuator message handling and the joint dispatch
    apply to any VESC-driven robot. It now lives in the vesc_dronecan_ros submodule
    as vesc_dronecan_driver, the same way the CRSF driver was extracted to elrs_ros
    and left rp1_elrs behind as glue. rp1 keeps what is genuinely rp1: geometry,
    DroneCAN id assignments, controller config and launch.
    New rp1_description holds the two URDFs. Descriptions had been living inside the
    hardware package, which is what made the coupling look deeper than it was -- a
    generic driver cannot ship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
    [rp1_controllers.yaml, rp1_drive.urdf, rp1_steering.urdf]
2026-07-26 Update docs for the extraction, and add a system graph to the README
    Every reference to rp1_hardware_interface across CLAUDE.md, README.md,
    docs/can_id_map.md, docs/wiring.md and simulation/README.md now points at
    vesc_dronecan_driver in the vesc_dronecan_ros submodule.
    The README gets a mermaid system graph, banded by ownership, because that is the
    thing the extraction changed and the thing a diagram shows better than prose:
    most of this stack is not rp1 code. rp1 owns the intent layer and the robot
    description, the kinematics are stock ros2_controllers, and the DroneCAN
    transport is a robot-agnostic sibling repo.
    Also corrects the build instructions, which were wrong as of the previous c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
2026-07-26 Document making vcan0 persistent across reboots
    The one-time setup only covers the current boot; a dev machine that
    repeatedly runs smoke dronecan or the simulator needs vcan0 back after
    every reboot. Add a systemd oneshot unit as the stack-agnostic fix.
2026-07-27 Wire rp1_description for FreeCAD-exported meshes
    Install meshes/ alongside urdf/, and reference chassis/wheel STLs
    (generated by rp1-mechanical's export_urdf_meshes.py) from
    rp1_drive.urdf's visual/collision geometry. Joint origins are still
    the old placeholder numbers until the meshes are actually exported
    and the real dimensions cross-checked against mechanical_request.xlsx.
    [rp1_drive.urdf]
2026-07-27 Populate rp1_description geometry from the CAD export
    Real, CAD-derived numbers replace the round placeholders in both
    URDFs and rp1_controllers.yaml: wheelbase 0.8m, track width 1.139m,
    wheel radius 0.215m (drive), plus steering pivot origins and gear
    ratio for the two bench-wired steering actuators. Neither
    docs/mechanical_request.xlsx nor mechanical design has confirmed
    these yet, and front/rear + left/right are an arbitrary pick (the
    chassis is symmetric both ways in the CAD) -- see the header comments
    in both URDFs. Adds the 5 exported meshes (chassis + 4 wheels).
    [rp1_controllers.yaml, rp1_drive.urdf, rp1_steering.urdf, wheel_front_left.stl, wheel_front_right.stl, wheel_rear_left.stl, wheel_rear_right.stl]
2026-07-27 Update rp1_drive.urdf header: front/rear convention confirmed
    No code/geometry change -- the chassis has no physical front-back or
    left-right distinction, so the axis convention picked in
    export_urdf_meshes.py is a settled, deliberate choice rather than an
    open question pending confirmation.
    [rp1_drive.urdf]
2026-07-27 Add a Gazebo-driven MVP pipeline via gz_ros2_control
    rp1_gazebo.launch.py runs the same joy -> rp1_teleop ->
    diff_drive_controller pipeline as rp1_mvp.launch.py, but through
    Gazebo physics: swaps rp1_drive.urdf's hardware plugin for
    gz_ros2_control/GazeboSimSystem (same string-substitution approach as
    the existing use_mock swap) and injects the <gazebo> system-plugin
    block gz_ros2_control needs. Requires ros-lyrical-gz-ros2-control
    (apt, not rosdep -- not part of a stock ROS2 desktop install).
    Needed two changes to rp1_drive.urdf to actually get a model into
    Gazebo, found by running it, not guessed:
    - Every link needs an <inertial> block or urdf2sdf silently drops it
    -- and everything dow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
    [rp1_drive.urdf]
2026-07-27 Correct keyboard teleop docs after end-to-end verification
    The "will start but never receive input" claim was wrong: with no
    controlling tty, teleop_twist_keyboard crashes immediately with
    termios.error, not a silent no-op. Verified end-to-end with a real
    controlling tty (a pty harness feeding synthetic keypresses, since
    this can't be tested by a human physically typing) that both
    launch files correctly drive the robot -- Gazebo physics and
    use_mock:=true odometry both moved under simulated keypresses.
    Also documents the actual practical failure mode users are likely to
    hit: OS window focus. teleop_twist_keyboard reads from its own
    terminal's stdin regardless of which window has focus, so c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
2026-07-27 Add keyboard teleop smoke test
    Drives the robot via a synthetic pseudo-terminal feeding
    teleop_twist_keyboard real keypresses (the only way to test raw
    termios keyboard capture without a human physically typing), and
    asserts odometry actually moved. Run against a live bringup
    (rp1_mvp.launch.py use_mock:=true or rp1_gazebo.launch.py, either
    with teleop:=false):
    python3 ros2_ws/src/rp1_bringup/test/keyboard_teleop_smoke_test.py
    Verified against both launch files. Two bugs fixed while writing it,
    documented in the script itself: `ros2 run`'s CLI wrapper adds enough
    startup latency that early keypresses are silently lost (fixed by
    invoking the module directly), and plain sys.exit() after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
2026-07-27 Wire an RViz config into rviz:=true on both bringup launch files
    rviz:=true already existed on rp1_mvp.launch.py and
    rp1_gazebo.launch.py, but started a blank rviz2 with no displays
    configured. Adds rp1_bringup/rviz/rp1_bringup.rviz (Grid, TF,
    RobotModel off /robot_description, Odometry off
    /diff_drive_controller/odom, Fixed Frame odom) and passes it via -d
    on both launch files. Verified: rviz2 starts with the config loaded
    and no errors.
2026-07-28 Add rqt_robot_steering mouse-driven teleop option
    rqt_steering:=true starts rqt_robot_steering instead of joy_node/
    rp1_teleop -- pass teleop:=false alongside it. It's a separate rqt
    window (not a panel docked inside rviz -- that would need a whole
    new C++ panel plugin), but drives the robot with mouse sliders while
    watching it move in rviz/Gazebo. Natively supports TwistStamped via
    its own default_stamped param, so like keyboard_teleop it needs no
    translator node.
    Requires ros-lyrical-rqt-robot-steering (apt, not rosdep -- not part
    of a stock ROS2 desktop install; see package.xml).
    Verified: launches cleanly and creates a TwistStamped publisher on
    /diff_drive_controller/cmd_vel correctly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
2026-07-30 Add second-wave sensor drivers: ICM20948 IMU (SPI) + u-blox M10 GPS
    rp1_imu: from-scratch ICM20948 9-DOF IMU driver over SPI (accel,
    gyro, AK09916 magnetometer via I2C-master passthrough). No stock
    ROS2 package covers this chip. UNVERIFIED against real hardware --
    no ICM20948 in this dev sandbox -- see the module docstring for
    what to check once hardware exists. Follows elrs_driver_node.py's
    established conventions: lazy hardware-lib import, require_spi:false
    dry-run, SPI errors logged not fatal.
    rp1_gps: config/launch glue for a u-blox M10 GNSS receiver over
    UART, using the stock ublox_gps package directly -- no custom driver
    code needed here, unlike the IMU.
    Both wired into rp1_mvp.launc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
    [icm20948_driver_node.py, rp1_imu.yaml]
2026-07-30 Correct steering encoder documentation, note new proximity sensors
    CLAUDE.md and docs/can_id_map.md both claimed the bench steering
    VESCs had no position feedback ("reported positions are meaningless
    FOC fighting phantom feedback"). Corrected 2026-07-30: the steering
    VESCs are specified to use an ABZ quadrature encoder for FOC position
    feedback. Not yet independently re-verified against the actual bench
    wiring -- this is a documentation correction based on new information,
    not a hardware confirmation.
    rp1_drive.urdf's and can_id_map.md's rationale for keeping steering
    joints out of rp1_drive.urdf no longer cites the (now outdated)
    "no encoder" reason -- the firmware ArrayCommand non-mainlin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
    [rp1_drive.urdf]
2026-07-30 Document drive VESC feedback sensor options (AB encoder or 3 Hall)
    Each drive VESC has both wireable, but only one selectable as the
    active FOC feedback sensor at a time -- which one rp1 uses isn't
    decided. Doesn't affect the DroneCAN protocol either way; noted as a
    hardware fact for VESC configuration, distinct from the steering
    VESCs' unrelated ABZ position encoder.
2026-07-30 Decide drive motor feedback sensor: Hall, not AB encoder
    Recommendation: Hall sensors. Sealed hub motors almost certainly
    already have them factory-wired (an encoder retrofit may not be
    mechanically possible), drive only ever needs velocity (position
    feedback already off, integrated from velocity), Hall tolerates an
    outdoor ag-robot's dust/moisture/vibration far better than an
    encoder needing precise alignment, and Hall+sensorless is VESC's
    most mature sensor mode. No DroneCAN protocol change either way --
    a VESC Tool hardware-configuration decision.
2026-07-30 Document shared VESC sensor port + AM26C32 diff-to-single converter
    Clarifies the physical wiring: Hall mode and ABZ encoder mode share
    the same VESC connector, just reinterpreted (3 Hall + temp, vs
    A/B/Z + temp) -- drive (Hall) and steering (encoder) use identical
    port types, not different connectors.
    The steering encoder's A/B/Z outputs are differential, not the
    single-ended levels that port expects in encoder mode -- an
    AM26C32-based converter board bridges them (spec sheet added to
    rp1-specs/assets/Diff2single.odt).
2026-07-30 Fold ADC1/2/3 + SSR + brake-type facts into swerve section; fix spec link
    rp1-specs/system_architecture.md was split into multiple files this
    session; update the cross-reference here accordingly, and fold in the
    newly-confirmed proximity-sensor (ADC1/ADC2) and steering-brake (ADC3 via
    SSR, electromagnetic on the motor shaft) hardware facts that also landed
    in rp1-specs/electrical_spec.md and requirements.md.
2026-07-30 Add rp1_swerve_controller package skeleton (no IK yet)
    Starts the swerve-drive controller_interface plugin on this branch,
    kept separate from master's 4-wheel-only MVP. Claims 4 drive velocity +
    4 steering position command interfaces (drive_joints/steering_joints
    params), subscribes ~/cmd_vel (TwistStamped), and has a working
    lifecycle -- but compute_corner_commands() always outputs 0 velocity /
    0 angle. No inverse kinematics, no 0/90-locked or 2-wheel operating
    modes (rp1-specs/requirements.md), no state feedback consumed, not
    wired into any launch file or URDF yet. Builds and installs cleanly,
    plugin registers correctly via pluginlib -- verified with colcon
    build/test. See the package READ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
    [rp1_swerve_controller.cpp, rp1_swerve_controller.hpp]
2026-07-30 rp1_steering.urdf: wire seek_home command + home switch status
    Adds, per steering joint, a "seek_home" command interface (write
    0.0/1.0 to send a COMMAND_TYPE_HOME actuator.Command -- see the
    vesc_dronecan_ros and bldc submodules' swerve branches) and a paired
    <gpio> block exposing home_0deg/home_90deg state, reusing the same
    actuator_id each joint already declares.
    Verified: check_urdf passes, and end-to-end against a real vcan0
    interface (steering_bench.yaml, can_iface temporarily pointed at vcan0
    for the test) -- ros2 control list_hardware_interfaces confirmed
    steering_front_right/rear_left's seek_home command interfaces and
    steering_sensors_front_right/rear_left's home_0deg/home_90deg s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
    [rp1_steering.urdf]
2026-07-30 Implement swerve inverse kinematics in rp1_swerve_controller
    Replaces the always-zero placeholder in compute_corner_commands() with
    real per-corner IK: rigid-body twist decomposition (vx, vy, wz) at each
    corner's steering-axis position (half_wheelbase/half_track params,
    defaulting to the CAD steering-axis geometry in
    rp1-specs/mechanical_spec.md -- NOT the drive-joint positions, which
    differ by the scrub radius), plus the angle-flip optimization (rotate
    <=90 degrees by allowing negative wheel speed instead of always
    steering to the literal computed angle), tracked against an unwrapped
    last-commanded-angle per corner for continuity across cycles on the
    continuous steering joints.
    Does not ye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
    [rp1_swerve_controller.cpp, rp1_swerve_controller.hpp]
2026-07-30 Add rp1_swerve.urdf: merged 4-drive + 4-steering description
    New file, not a rewrite of rp1_drive.urdf (MVP, stays drive-only) or
    rp1_steering.urdf (2-actuator bench description, stays as-is) -- this
    is the merged description rp1/CLAUDE.md's "Extending to full swerve"
    section anticipated once a swerve controller exists (it does now, see
    rp1_swerve_controller).
    Correct link hierarchy per corner: base_link -> steering_X_link ->
    wheel_X_link (steering joint then drive joint hanging off it), not
    base_link -> wheel_X_link directly like rp1_drive.urdf -- necessary for
    the visual model to actually show the wheel turning when steering is
    commanded. Each drive joint's origin relative to its steering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
    [rp1_swerve.urdf]
2026-07-30 Add rp1_swerve_mock.launch.py: swerve IK visible on screen, no CAN/Gazebo
    The "watch it before trusting it on the robot" bringup: rp1_swerve.urdf
    + mock_components/GenericSystem + rp1_swerve_controller + rviz2, no
    CAN/DroneCAN/Gazebo physics involved. rp1_swerve_controller was still
    an always-zero placeholder as of the last commit; this is the first
    bringup that actually exercises its now-real IK end-to-end against the
    real URDF/mesh and a real ros2_control activation.
    New rp1_swerve_controllers.yaml (controller_manager config: joint_state_
    broadcaster + rp1_swerve_controller, drive/steering joint lists,
    half_wheelbase/half_track matching rp1_swerve.urdf's steering-axis
    geometry) and rp1_sw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
    [rp1_swerve_controllers.yaml]
2026-07-30 Add odometry to rp1_swerve_controller: it actually drives in RViz now
    compute_body_twist() closes the loop the other way from
    compute_corner_commands(): reads back drive velocity + steering
    position *state* (wheel_radius param converts angular velocity to
    linear speed) and solves the same rigid-body-twist equations as the
    IK, in reverse. Exact (not approximate) for this controller's
    always-rectangular corner geometry -- the normal equations for the
    general least-squares problem are diagonal here (sum(x_i)=sum(y_i)=0
    for the four +/-half_wheelbase, +/-half_track corners), so it reduces
    to three independent averages rather than needing a real 3x3 solver or
    an Eigen dependency.
    Publishes nav_m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
    [rp1_swerve_controllers.yaml]
2026-07-30 Add 0/90-locked and 2-wheel operating modes to rp1_swerve_controller
    Implements the 4 operating modes from rp1-specs/requirements.md's "Why
    swerve, and what it needs to do", selected via a new ~/mode topic
    (std_msgs/UInt8, SwerveMode enum):
    - LOCKED_0/LOCKED_90: all 4 wheels held at a fixed angle, driven by
    projecting the same rigid-body-twist vector (already computed for the
    free-swerve IK) onto that fixed direction instead of solving for a
    free angle. For LOCKED_0 this is algebraically identical to standard
    skid-steer differential drive (vx -/+ wz*half_track per side, same
    convention as diff_drive_controller) -- no separate skid-steer code
    path needed, just a projection of the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
    [rp1_swerve_controller.cpp, rp1_swerve_controller.hpp]
2026-07-30 Make TWO_WHEEL's steered pair configurable, not hardcoded to front
    Was hardcoded to front_left/front_right free-steering with the rear
    pair locked. Now a two_wheel_steered_corners parameter (list of exactly
    2 of front_left/front_right/rear_left/rear_right) picks which 2 free-
    steer -- any combination is valid: front pair (still the default),
    rear pair, one front + one rear, both on one side, or diagonal corners.
    compute_corner_commands()'s TWO_WHEEL case now checks
    !two_wheel_steered_[i] instead of a hardcoded REAR_LEFT/REAR_RIGHT
    comparison.
    Verified live against the mock bringup with a genuinely different pair
    (front_left/rear_left, via a --param-file override) -- confirmed those
    two now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
    [rp1_swerve_controllers.yaml]
2026-07-31 Add rp1_swerve_dronecan.launch.py, fix dronecan driver-dispatch bug in simulators
    Wires rp1_swerve.urdf to the real vesc_dronecan_driver plugin (actual DroneCAN
    wire framing, not mock_components). Fixes a real bug found while verifying it
    over vcan0: dronecan.driver.make_driver() always prefers its PythonCAN driver
    over native SocketCAN whenever python-can is importable, and that path is
    broken against python-can 4.6.1 (broadcasts silently vanish, spin() hangs).
    Both simulator scripts now force the native SocketCAN driver instead.
    Confirmed end-to-end: driving straight against vcan0 with both simulators
    running produces real nonzero drive-wheel velocity/position in /joint_states,
    round-trip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
    [sim_actuator_node.py, sim_vesc_node.py]
2026-07-31 Document steering feedback now verified over real DroneCAN too
    Follow-up to the earlier drive-only verification: a turn-in-place command
    now produces steering joint_states matching the hand-computed full-swerve
    angles exactly, fixed by a vesc_dronecan_ros bug where actuator.Status's
    decoder hard-failed its entire decode whenever the private home_0deg/
    home_90deg extension bits were absent (which they always are from a
    standard, non-extended sender like sim_actuator_node.py).
2026-07-31 Gate locked-mode transitions on home_0deg/home_90deg confirmation
    Closes the gap rp1-specs/requirements.md flagged: a switch into LOCKED_0/
    LOCKED_90/TWO_WHEEL used to command the locked angle immediately based on
    whatever the controller last computed, with no check that the physical
    0/90-degree reference was actually confirmed. compute_corner_commands() now
    reads each locked corner's home_0deg/home_90deg gpio state live every cycle
    (no separate "have we ever homed" bookkeeping -- a corner that later drives
    off the reference naturally stops reporting it and re-gates next time).
    While any locked corner isn't yet confirmed, every drive wheel is held at
    zero (not just that corner, to avoid scru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
    [rp1_swerve_controller.cpp, rp1_swerve_controller.hpp, test_rp1_swerve_controller.cpp]
2026-07-31 Gate mode switches on the chassis being confirmed stopped
    Closes the remaining half of rp1-specs/requirements.md's mode-switch-safety
    gap: the home_0deg/home_90deg gate only fires when a corner's target angle
    isn't yet confirmed, so a switch between two modes wanting the SAME angle
    for their locked corners (e.g. LOCKED_0 -> TWO_WHEEL's default pair) took
    effect immediately with no stop-first requirement.
    update() now computes the chassis's real, state-feedback-derived body twist
    every cycle (compute_body_twist(), already used for odometry) and only
    commits a requested ~/mode value to active_mode_ -- the mode
    compute_corner_commands() actually acts on -- once vx/vy/wz all read below
    mode_swi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
2026-07-31 Wire rp1_swerve.urdf into Gazebo physics via gz_ros2_control
    Adds rp1_swerve_gazebo.launch.py: swaps in gz_ros2_control's GazeboSimSystem
    the same string-substitution way the mock/DroneCAN tiers already swap their
    own hardware plugin, spawns into gz sim (headless by default, this sandbox
    has no display), bridges /clock, and spawns the same joint_state_broadcaster
    + rp1_swerve_controller controllers.
    GazeboSimSystem only backs standard joint interfaces (position/velocity/
    effort) with a real Gazebo entity -- no Gazebo entity exists for seek_home or
    any <gpio> block (ESC telemetry, home_0deg/home_90deg), so it can't export
    them. controller_manager's resource manager refuses to activate a cont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
    [rp1_swerve.urdf]
2026-07-31 Add CI: colcon build/test against lyrical, with sibling repos checked out
    Mirrors robotpicks.sh's own build_rp1/cmd_test logic exactly: checks out
    elrs_ros and vesc_dronecan_ros as siblings (the two robot-agnostic packages
    rp1's workspace needs but that don't live under ros2_ws/src), rosdep
    installs across all three source trees, then colcon build/test with the
    same --base-paths every local build in this project's history has used.
    Each sibling tracks its own repo's default branch, not this branch's name --
    so this job is expected to fail until the matching vesc_dronecan_ros PR
    merges, since this branch currently depends on unmerged interfaces there.
    That's a real, useful signal, not a CI b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
2026-07-31 Fix CI: pass a token to check out the private vesc_dronecan_ros repo
    The default GITHUB_TOKEN a workflow run gets only grants access to the repo
    it's running in -- checking out a different private repo in the same org
    needs an explicit token. Added a CROSS_REPO_TOKEN repo secret (a PAT with
    read access) and wired it into that checkout step.
2026-07-31 CI: explicitly install ros2_control metapackages as a broader safety net
    Same reasoning as the matching vesc_dronecan_ros CI change: setup-ros only
    installs ros-<distro>-desktop by default, and the ros2_control stack is a
    separate metapackage group. rosdep install already resolves everything
    correctly on its own (this workflow already passed without this), but
    installing ros-lyrical-desktop-full + ros2-control + ros2-controllers
    explicitly matches the broader dev sandbox this project is actually
    built/tested in.
2026-07-31 Add ros2_control representation for the steering-hold brake
    Closes rp1-specs/requirements.md's "Brake on steering requirement" gap:
    the firmware side (bldc's COMMAND_TYPE_BRAKE) already existed, but nothing
    on the ROS 2 side claimed or drove it. Adds a "brake" command interface to
    rp1_swerve.urdf's steering joints (matching seek_home's pattern) and a
    steering_brake_available controller parameter (mirroring
    steering_home_sensors_available) so gz_ros2_control's GazeboSimSystem --
    which has no physical brake output to back this with -- can opt out
    without controller_manager refusing to activate.
    rp1_swerve_controller engages the brake (1.0) exactly when a corner is
    locked to a fixed angle in t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
    [rp1_swerve.urdf]
2026-07-31 Tune Gazebo joint physics, fix drive-command units bug, add mode-switch ramping
    rp1_swerve.urdf was missing effort/velocity limits and damping on every drive
    and steering joint, and steering had no declared position_proportional_gain --
    gz_ros2_control's GazeboSimSystem only exposes that one gain for position
    control, so convergence toward a step-changed target was implausibly slow.
    Added placeholder <limit>/<dynamics> tags plus the gain param.
    While comparing Gazebo's converged wheel velocity against the commanded value
    during that tuning, found compute_corner_commands() sent linear m/s straight
    to the angular (rad/s) drive velocity command interface with no divide by
    wheel_radius -- the r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
    [rp1_swerve.urdf]
2026-08-01 Loopback checker: default wheel radius to the CAD value
    rp1_controllers.yaml's wheel_radius moved to the CAD-export 0.215396,
    but the checker still graded against the 0.1 placeholder, so a fully
    working loopback failed with all four wheels uniformly at
    speed/0.215396 = 2.3 rad/s instead of the expected 5.0. First surfaced
    by CI's dronecan-vcan job on its first run to ever reach the checker.
    [check_dronecan_loopback.py]
2026-08-01 rp1_swerve_controller: add a cmd_vel staleness watchdog
    update() latched the last twist forever, so a dead publisher (teleop
    crash, RC dropout, an exited `ros2 topic pub`) left the robot driving
    its last command indefinitely -- observed live under Gazebo, still
    strafing at 0.3 m/s a minute after the publisher stopped.
    A command whose header.stamp is older than cmd_vel_timeout (default
    0.5 s, same name/role/value as diff_drive_controller's) now counts as
    no command at all: drive velocities zero while steering keeps holding
    last_steering_angle_ -- coasting out straight instead of snapping the
    wheels to 0 degrees mid-roll. Unstamped messages are stamped at
    reception so they age too; a pending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
    [rp1_swerve_controllers.yaml]
2026-08-01 CI: drop CROSS_REPO_TOKEN -- vesc_dronecan_ros is public now
    Same de-tokenization the robotpicks meta repo already did for its
    SUBMODULE_TOKEN: the org's repos went public, so the anonymous checkout
    works and the PAT was only an expiry-shaped time bomb.
2026-08-05 Add rp1_compass (IST8310) driver; confirm Waveshare converter pinout and ELRS wiring on the bench
    Bench confirmation 2026-08-05: the Waveshare converter runs in Mode 1 (UART1 + I2C + SPI,
    UART0 disabled) carrying the IMU (SPI), GPS (UART1, enumerates /dev/ttyACM0), and the GPS
    module's onboard IST8310 compass (I2C) -- corrects the earlier assumption that ELRS shared
    this converter too; ELRS is confirmed to be its own separate FTDI /dev/ttyUSB0-style device.
    GPS hardware is confirmed as a Dalang DL25F10NQ (NEO-F10N + IST8310), correcting the earlier
    "u-blox M10" placeholder.
    Adds rp1_compass: an IST8310 magnetometer driver over I2C, written from the public register
    map, unverified against re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
    [ist8310_driver_node.py, rp1_imu.yaml]
2026-08-05 Add SPI/I2C/UART bus continuity bench check
    Confirms the Waveshare converter's three buses are alive before any sensor
    is attached, following the same require_*/dry-run precedent as the
    icm20948/ist8310/elrs drivers. Wired in as `./robotpicks.sh smoke bus`.
2026-08-05 Rewrite SPI/I2C bus checks against WCH's ch34x_pis driver + libch347.so
    The Waveshare converter's SPI/I2C interface (WCH CH347, Mode 1) isn't a
    generic Linux spidev/i2c-dev device -- confirmed the in-tree spi-ch341
    driver only matches CH341A's USB PID (0x5512), not this converter's
    (0x55db), and CH347 speaks a different wire protocol besides. Real access
    is through WCH's out-of-tree ch34x_pis.ko (WCHSoftGroup/ch341par_linux)
    creating /dev/ch34x_pis0, spoken to via their libch347.so.
    Adds ch347lib.py (ctypes bindings for the SPI/I2C subset needed here, field
    layout and call signatures transcribed from WCH's own ch347_lib.h) and
    99-ch34x-pis.rules (udev permission fix so this doesn't need roo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
    [ch347lib.py, check_bus_continuity.py]
2026-08-05 Auto-bring-up can0 via udev: bitrate 1000000 on every boot/replug
    Confirmed on the bench: this gs_usb adapter's firmware rejects restart-ms
    ("Device doesn't support restart from Bus Off"), so no automatic bus-off
    recovery -- a bus-off still needs a manual down/up or replug. Verified the
    rule fires correctly on a real hot-replug (interface index changed 5->6,
    came back up with bitrate already configured, zero errors).
2026-08-05 Add real-hardware CAN comm test tool: listen for esc.Status, pulse one esc_index
    For docs/wiring.md's bring-up order steps 2-3 (one VESC + motor at a time on
    the real can0 bus before trusting the full pipeline). No reusable real-can0
    sender existed -- simulation/sim_vesc_node.py only simulates VESCs, it
    doesn't command them. Reuses that file's dronecan+python-can workarounds
    (force native SocketCAN, spin(timeout=0) only).
    `listen` is passive/always-safe. `pulse` sends a real RawCommand duty pulse
    to one esc_index and always zeros it on exit; requires wheels off the
    ground and an explicit typed confirmation before sending anything.
    Verified `listen` against the real can0 bus: correctly repo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
    [can_vesc_test.py]
2026-08-05 Document Bluetooth Xbox pad driver correction: hid_xpadneo, not hid_microsoft
    Confirmed on the bench after pairing via bluetoothctl: this box has the
    third-party xpadneo driver installed, a known-more-stable BLE HID driver for
    Xbox pads specifically written to avoid the flapping issue the surrounding
    text warns about.
2026-08-05 can_vesc_test.py listen: report node ID + hardware UUID per esc_index, flag node ID 0
    GetNodeInfo each distinct DroneCAN node ID seen so bench units can be told apart
    by their PROM ID/UUID before assigning esc_index/CAN ID via VESC Tool. Also
    prints a label/task column from can_id_map.md's wheel/steering conventions, and
    flags esc.Status seen at a steering actuator_id (4-7) as a config mismatch.
    can_id_map.md: document that DroneCAN node ID 0 is the reserved anonymous
    address, not a valid VESC CAN ID, even though VESC Tool's own field permits 0.
2026-08-05 can_vesc_test.py: fix wrong MISMATCH label, firmware sends both status types unconditionally
    Verified against bldc/libcanard/canard_driver.c's periodic status loop: it calls
    sendEscStatus() and sendActuatorStatus() unconditionally every period for every
    VESC, regardless of intended role. So esc.Status at a steering actuator_id
    (esc_index 4-7) is normal, not a config mismatch as the previous label claimed --
    role is decided by which command message the PC sends, not which status message
    comes back. Replaced the false MISMATCH flag with an accurate note.
    [can_vesc_test.py]
2026-08-05 Renumber esc_index/actuator_id convention to 1-8, add esc_index collision detection
    All 8 VESCs (4 drive + 4 steering) are now physically on the robot, no longer a
    bench-only subset. Renumber can_esc_index from 0-7 to 1-8 across
    docs/can_id_map.md and every URDF that declares it (rp1_drive, rp1_steering,
    rp1_swerve): drive esc_index 1-4, steering actuator_id 5-8 (= drive + 4,
    formula unchanged). Index 0 is deliberately left unused so no VESC is ever
    left at a default-looking unconfigured value. This is a pure rp1 convention,
    not a UAVCAN protocol requirement -- unlike DroneCAN node ID 0, which is a
    real reserved address (see the earlier node ID 0 fix).
    can_vesc_test.py listen: key seen stat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
    [rp1_drive.urdf, rp1_steering.urdf, rp1_swerve.urdf]
2026-08-06 docs: correct CANable firmware to v2.1 CANable_MKS (board-specific F072 target)
    Confirmed on the bench 2026-08-06: the previously-documented v2.0 canable_fw.bin
    is an F042 target (original CANable/CANtact design) -- it happened to run on
    this board's actual STM32F072C8Tx but wasn't correct for it. v2.1 adds a
    CANable_MKS target that's F072-specific and matches this board, but has no
    prebuilt release, so it must be built from source. Also documents a Ubuntu
    gcc-arm-none-eabi packaging bug (missing nano.specs in gcc's own spec search
    path) and its one-time symlink fix, found while building it.
2026-08-06 Add PyQt5 GUI bench tool: live esc.Status monitor (can_vesc_gui.py)
    GUI counterpart of can_vesc_test.py's 'listen' mode -- a live-updating table of
    esc_index/node_id/UUID/rpm/voltage/current/temp instead of a fixed-duration CLI
    snapshot, for walking the bench toggling VESCs on/off. Passive only, reuses
    can_vesc_test.py's wheel-index table and DroneCAN driver workarounds.
    [can_vesc_gui.py]
2026-08-06 docs: mention can_vesc_gui.py alongside can_vesc_test.py listen
    Same per-esc_index/node_id/UUID/rpm/voltage/current/temp verification, just as
    a live-updating table instead of a fixed-duration CLI snapshot.
2026-08-06 docs: bench-confirm drive VESC node IDs, document s_pid_min_erpm gate and missing Hall wiring
    Wheel-by-wheel bring-up (wiring.md steps 2-4) surfaced two real issues beyond this repo's
    own code: firmware's speed-PID never engages below s_pid_min_erpm (default 900), which is
    above this robot's actual commanded ERPM range, and none of the 4 drive motors actually have
    their Hall sensor connected despite the 2026-07-30 decision to use them. Both fixed/deferred
    on the bench; rear-left (esc_index 3) still misbehaves and is tracked as an open issue.
2026-08-30 sim_vesc_node: track ESCs by the esc_index the commands actually carry
    The URDF assigns drive esc_index 1..4; the sim modelled a hard-coded 0..3,
    so rear_right (index 4) never got its command nor sent Status -- CI's
    dronecan-vcan loopback failed deterministically with that one wheel at
    0.000 rad/s. Wheels are now created on first nonzero command for whatever
    index appears (capped at NUM_WHEELS), and Status echoes those indices.
    Claude-Session: https://claude.ai/code/session_01AoJ2odopE2rozKKCX5QuzB
    [sim_vesc_node.py]
2026-08-30 Move per-ESC <gpio> telemetry to a gpio_controllers state broadcaster
    This ROS release's joint_state_broadcaster dropped /dynamic_joint_states
    and its publish_dynamic_joint_states/use_urdf_to_filter parameters -- it
    publishes plain /joint_states only, so the per-ESC voltage/current/
    temperature silently vanished (CI's loopback phase 2 caught it: 'no per-ESC
    voltage at all').
    The telemetry now has its own controller: gpio_controllers/
    GpioCommandController in state-only configuration (esc_telemetry_broadcaster,
    spawned after diff_drive_controller), publishing
    control_msgs/DynamicInterfaceGroupValues on
    /esc_telemetry_broadcaster/gpio_states. Both consumers ported:
    rp1_elrs/esc_telemetry_to_b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
    [rp1_controllers.yaml, rp1_swerve_controllers.yaml]
2026-09-06 docs: drive sensor mode moved to AB encoder; rear-left/right CAN IDs confirmed
    Supersedes the 2026-08-06 sensorless-interim state: all 4 drive VESCs now
    run FOC_SENSOR_MODE_ENCODER_AB (confirmed live, e.g. rear-left reading
    foc_sensor_mode=9, m_encoder_counts=16348), bypassing the open Hall-wiring
    question rather than resolving it. Also records that rear-left/rear-right
    had scrambled uavcan_esc_index values (in the steering 5-8 range instead
    of drive 1-4) that are now fixed and confirmed via can_vesc_test.py listen.
    Claude-Session: https://claude.ai/code/session_01HaoXnQ8ggQkYZu66f8EBXz
2026-09-06 docs: bench-confirm drive wheel spin direction; fix front-right/rear-right
    Both right-side drive VESCs spun in reverse on a positive esc.RPMCommand
    -- expected from mirrored left/right motor mounting, not a wiring fault.
    Fixed via VESC Tool's m_invert_direction flag (front-right, rear-right
    both set to 1); left-side wheels already correct at the default (0).
    Verified per-wheel by pulsing individually and observing forward motion.
    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
2026-09-06 docs: correct drive sensor mode to AB encoder, flag uncalibrated offset/ratio
    Direct CAN read of foc_sensor_mode on all 4 drive VESCs shows 9
    (FOC_SENSOR_MODE_ENCODER_AB), not sensorless as the prior 2026-08-06 note
    assumed. foc_encoder_offset=0.000 and foc_encoder_ratio=100.000 identically
    on all 4 look like uncalibrated defaults rather than real detection results,
    likely explaining weak/underpowered torque independent of the (already wide
    open) current and watt limits.
    Claude-Session: https://claude.ai/code/session_01JboeGZKD1smN6bX4Fgtoim
2026-09-14 tools: add can_vesc_test.py watch, live RPMCommand vs Status comparison
    Decodes esc.RPMCommand directly off the bus (the actual CAN bus command
    per esc_index) next to that wheel's esc.Status feedback, continuously,
    so a command/feedback mismatch is visible live while driving instead of
    only inferable after the fact.
    Claude-Session: https://claude.ai/code/session_01NUsiBTgQLHdzHBoH3tP7St
2026-09-14 docs: rear-left (esc_index 3) misbehavior resolved, connector reseated again
    Same phase connector as the 2026-08-06 event worked loose a second time;
    reseating it cleared the oscillating-rpm/elevated-current symptom. Motor/
    wiring, not the VESC or stale FOC detection as hypothesized.
    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
2026-09-14 fix: motor_pole_pairs was an unconfirmed 7.0 placeholder, real motors are 20 pairs
    Bench-confirmed 20 magnet pairs (40 poles) on the drive motors. The wrong
    value made vesc_dronecan_driver undercommand ERPM to ~35% of what a given
    wheel speed actually needed -- spinning correctly via VESC Tool's own
    RPM/current control (no external pole-pair conversion involved) but very
    slow and jittery via RPMCommand over CAN. Fixed in both drive/swerve URDFs
    and kept can_vesc_test.py watch's and sim_vesc_node.py's --pole-pairs
    defaults in step.
    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
    [rp1_drive.urdf, rp1_swerve.urdf]
2026-09-14 fix: remap drive esc_index after 90-degree chassis reorientation
    Chassis was physically turned 90 degrees (old right side is now front).
    esc-to-motor wiring is unchanged; only which URDF corner each esc sits
    at moved: esc2->front-left, esc4->front-right, esc1->rear-left,
    esc3->rear-right. Updated rp1_drive.urdf and rp1_swerve.urdf (joint +
    gpio blocks) and docs/can_id_map.md. diff_drive_controller's left/right
    wheel_names needed no change since they key off joint name, not
    esc_index. Flagged m_invert_direction as not yet re-verified against
    the new forward direction.
    Claude-Session: https://claude.ai/code/session_01MBgVWnpmf2Sj82M6WGk3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
    [rp1_drive.urdf, rp1_swerve.urdf]
2026-09-14 feat: add front_is launch arg to switch esc_index preset at launch time
    Two presets for the drive esc_index-to-corner mapping, selected via
    front_is:=right (default, matches the current 90-degree-reoriented
    chassis) or front_is:=front (original, pre-reorientation mapping).
    Lets the URDF esc_index be swapped without hand-editing rp1_drive.urdf
    each time the chassis orientation changes on the bench.
    Claude-Session: https://claude.ai/code/session_01MBgVWnpmf2Sj82M6WGk34e
2026-09-14 docs: declare esc_timeout_sec in rp1_drive.urdf/rp1_swerve.urdf
    Documents the new vesc_dronecan_driver esc-presence watchdog param at
    its default value (0.5s) -- see vesc_dronecan_ros's README for the
    behavior. No functional change (matches the driver's own default).
    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
    [rp1_drive.urdf, rp1_swerve.urdf]
2026-09-14 docs: confirm firmware timeout_msec/timeout_brake_current on a drive VESC
    Read directly over USB via vesc_tool --getAppConf on esc_index 3:
    1000ms / 0.0A, both unmodified firmware defaults. Documents how this
    relates to vesc_dronecan_ros's new esc_timeout_sec watchdog (separate,
    lower-level, per-VESC vs. coordinated bus-wide). Not independently
    confirmed on esc_index 1/2/4 -- vesc_tool --canFwd hit a serial I/O
    error reaching any forwarded target, including a known-good one, so
    assumed but unverified for those three.
    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
2026-09-15 fix: widen can0 SJW to fix CAN bus noise (ERROR-PASSIVE flapping)
    Bench-confirmed 2026-09-15: can0's default sjw 2 (from a plain
    `bitrate 1000000`) left it unable to track as much per-bit drift as
    the VESCs' own controllers tolerate, which run at their hardware max
    SJW (4 tq -- see bldc's comm/comm_can.c). Result: ~60% of bus traffic
    was error-class frames (mostly FORM errors at the CRC-sequence/EOF
    tail, the one stretch of a frame with no bit-stuffing edges to
    resync on), can state flapping ACTIVE/ERROR-PASSIVE continuously.
    Switched 80-can0-up.rules and the manual bring-up steps in
    wiring.md to the explicit tq/prop-seg/phase-seg1/phase-seg2 form
    (same 1Mbit/s, 75% sample point a plain `bi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
2026-09-22 tools: fix can_vesc_test.py wheel labels for chassis reorientation
    _WHEEL_NAMES still had the pre-2026-09-14 esc_index-to-corner mapping,
    so listen/watch printed esc_index 1 as "Front-left" when the
    90-degree reorientation made it rear-left (see docs/can_id_map.md).
    esc-to-motor wiring didn't change, only which corner each index sits
    at now. Verified against a live listen run: labels now match
    can_id_map.md's table (2=FL, 4=FR, 1=RL, 3=RR).
    [can_vesc_test.py]
2026-09-22 Fix motor_pole_pairs (7.0->10.0), bench-tune drive speed-PID to Kp=0.006/Ki=0.002
    Wrong pole-pair count was scaling every ERPM command sent to the drive VESCs.
    Bench-reproduced the standstill/low-speed oscillation report under real load,
    found and fixed a can_status_msgs_r1 CAN flood on two VESCs that was also
    distorting feedback, then swept s_pid_kp/s_pid_ki with the robot actually
    driving. Kp=0.006/Ki=0.002 is a real improvement over stock but not a clean
    fix; Kp>=0.02 has real torque authority but is confirmed unsafe on this
    drivetrain (drove into a wall twice during testing). Full writeup in
    docs/can_id_map.md's "Speed-PID gain tuning" section.
    [rp1_drive.urdf, rp1_swerve.urdf]
2026-10-17 rp1_swerve_controller test: make OdometryIntegratesStraightLineDistance deterministic
    The test read "the latest ~/odom" after 50 moving cycles plus a few spins,
    but try_publish() drops a cycle's message whenever the realtime publisher's
    background thread is busy, so the final moving cycles may never be
    published at all. CI saw 0.88 m (44 cycles) against a 1.0 +/- 0.05 m
    expectation; locally with all cores loaded the old test failed 31/40 runs
    (0.18-0.82 m).
    Now stop the wheels after the 50 moving cycles and keep cycling until a
    zero-twist message arrives. Odometry is explicit Euler on period, so
    stopped cycles add exactly nothing and that message carries the pose after
    all 50 moving cycles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
